LucaSchenetti/ESP32-Analog-Board/3-Gerber File & BOM/BOM_Rev_B.xlsx

Comment | Designator | Footprint | JLCPCB Part #（optional）
10u | C1, C3, C42, C48, C57 | CAP_0402 | C15525
100n | C2, C4, C8, C9, C10, C15, C16, C17, C18, C20, C21, C22, C31, C33, C34, C39, C43, C49, C58, C63, C64, C76 | CAP_0402 | C307331
1u | C5, C6, C7, C32, C35, C40, C62, C65 | CAP_0402 | C52923
1p2 | C11 | CAP_0402 | C76899
1p5 | C12 | CAP_0402 | C76900
15p | C13, C14 | CAP_0402 | C1548
22n | C19 | CAP_0402 | C1532
10u | C23 | CAP_ALEL_5x5.4 | C46550416
4u7 | C24, C53 | CAP_0805 | C98192
10u | C25, C27, C54, C67 | CAP_0805 | C440198
100n | C26, C68, C69, C79 | CAP_0603 | C14663
1u | C28, C44, C45, C46, C47 | CAP_0805 | C28323
10u | C30, C36, C37, C38, C56, C77, C78 | CAP_0603 | C194427
4u7 | C41 | CAP_0402 | C23733
2n7 | C50, C52 | CAP_0402 | C106251
27n | C51 | CAP_0402 | C880636
1u | C55 | CAP_0603 | C15849
1n | C59, C61 | CAP_0402 | C1523
10n | C60 | CAP_0402 | C15195
47u | C66 | CAP_ALEL_6.3x5.4 | C48971023
47n | C70 | CAP_0603 | C1622
47p | C71 | CAP_0603 | C1671
22u | C72, C73, C81, C82 | CAP_0603 | C59461
2u2 | C74, C75 | CAP_0402 | C12530
56p | C80 | CAP_0603 | C39148
DIODE 300mA 75V | D1, D6, D11 | 1N4148W | C917030
BLUE | D2 | LED_0603_BLUE | C965807
RGB_LED | D3 | XL-2012RGBC | C965848
YELLOW | D4 | LED_0603_YELLOW | C89811
Schottky Diodes | D5, D9 | BAT54S | C7420333
TVS 30V Bidirectional | D7 | SMBJ30CA | C83847
BIDI TVS 36V | D8, D12, D13, D14 | SMAJ33CA | C19077549
BIDI TVS 24V | D10 | SMAJ30CA | C10755
ZENER DIODE 15V | D15 | BZT52C15 | C19077412
BIDI TVS 30V | D16, D17 | SMAJ30CA | C10755
ESD Protection TVS 6.0V | D18 | SMF6.0CA | C123791
TWO LED GREEN | D19 | TJ-L3F2LTQYKMQFLC7K-A5 | C20613347
PPTC 100mA 60V | F1, F2 | JK-nSMD010/60V | C2830236
RESETTABLE FUSE 100mA | F3 | BSMD1812-010-60V | C883137
PTC 60V 500mA | F4 | mSMD050-60V | C70113
120R | FB1 | FB_0402 | C76891
DPDT | J1 | 2MD3T2B1M6RES | C545196
2nH | L1 | IND_0402 | C18216
2n7 | L2 | IND_0402 | C77108
6.8uH | L3 | FXL0530-6R8-M | C177249
4.7uH | L4 | IND-SMD_L4.4-W4.2 | C5349668
WJ500V-5.08-4P | P1 | WJ500V-5.08-4P | C2915641
WJ500V-5.08-5P | P2 | WJ500V-5.08-5P | C2927513
2P PLUGGABLE TERMINAL BLOCK 3.81MM | P3 | WJ15EDGRC-3.81-2P | C8387
MALE CONN 2P 3.81mm | P4 | WJ15EDGK-3.81-2P | C8466
N-Channel Vgs=30V 5.7A | Q1 | AO3400A | C20917
NPN MOSFET 100V | Q2 | IRLR3110ZTRPBF | C67277
P-Mosfet 60V 3A | Q3 | BSP315P | C5246415
180R | R1, R6 | RES_0402 | C138045
1K | R2, R5, R8, R53, R54 | RES_0402 | C11702
5K1 | R3, R4, R51, R52 | RES_0402 | C25905
75R | R7, R9 | RES_0402 | C25133
4K7 | R10 | RES_0603 | C23162
100K | R11, R47 | RES_0603 | C25803
100K | R12 | RES_0402 | C25741
10K | R13 | RES_0805 | C17414
33R | R14, R17 | RES_0603 | C23140
10K | R15, R41, R44 | RES_0402 | C25744
25R5 | R16, R34 | RES_2512 | C2775912
47R | R18, R28 | RES_0603 | C23182
15K4 | R19 | RES_0603 | C2933150
1K | R20 | RES_0603 | C21190
2K2 | R21 | RES_0603 | C4190
240R | R22 | RES_0603 | C23350
15K | R23 | RES_0805 | C17475
715R | R24 | RES_0603 | C2998136
10R | R25, R36, R38 | RES_0402 | C25077
1M13 | R26 | RES_0402 | C51048313
499K | R27 | RES_0402 | C2998054
5K1 | R29 | RES_2010 | C2999618
4K12 | R30, R35 | RES_0603 | C23041
47R | R31, R32, R33, R39 | RES_0402 | C25118
470R | R37 | RES_2010 | C2933989
90K9 | R40 | RES_0603 | C23129
10K | R42 | RES_0603 | C25804
9K09 | R43 | RES_0603 | C23125
4R7 | R45 | RES_2512 | C25489
158K | R46 | RES_0603 | C22883
30K1 | R48, R56 | RES_0603 | C137745
150K | R49 | RES_0402 | C93947
68K | R50 | RES_0402 | C2909379
93K1 | R55 | RES_0603 | C23266
TS-1088-AR02016 | SW1, SW2 | TS-1088-AR02016 | C720477
Passive Buzzer 4kHz | U1 | KLJ-4020 | C556936
TRANSISTOR NPN | U2 | SS8050 | C2150
ESP32-S3 8MB IN FLASH | U3 | ESP32-S3FN8 | C2913196
Schmitt Trigger 1.65V~5.5V | U4 | 74LVC1G14GW,125 | C265125
Digital to Analog Converters 12 SPI Voltage Buffer | U5 | AD5412AREZ-REEL7 | C27993
Precision Op Amps | U6 | OP184ESZ-REEL7 | C209423
LDO 100mA 2,2-37V | U7, U10 | LM317LDR2G | C7940
INVERTED CHARGE PUMP 2.7V~5.5V | U8 | LM27761DSGR | C129351
Digital Isolators 4 IN - 2 OUT | U9, U13 | NSI8262W1-DSWR | C5441133
ADC 24-Bit 4-Channel | U11 | ADS1220IPWR | C48263
LDO 3,3V 250mA | U12 | HT7333-A | C347191
3.8V~32V 3A 500kHz | U14, U16 | AP63301WU-7 | C2158003
TVS USB 2.0 ±25-kV | U15 | TPD2E2U06DRLR | C1972959
USB-C CONNECTOR 16P VERTICAL | USB1 | TYPEC-305-ACP16H458 | C5454943
40MHz | X1 | XTAL_3225 | C5261245
4.096MHz CMOS ±10ppm ±20ppm | X2 | OT32254.096MJBA4SL | C2831395
Isolated Power IN 4.5V~5.5V OUT 24V 2W | Y1 | B0524S-2WR3 | C5369477
Isolated Power IN 4.5V~5.5V OUT 24V | Y2 | B0524S-1WR3 | C7500908
Isolated Power 21.6V~26.4V | Y3 | B0505S-1WR3 | C7465178
