LucaSchenetti/ESP32-Analog-Board/10-3D Case/STEP FILE/BASE.step

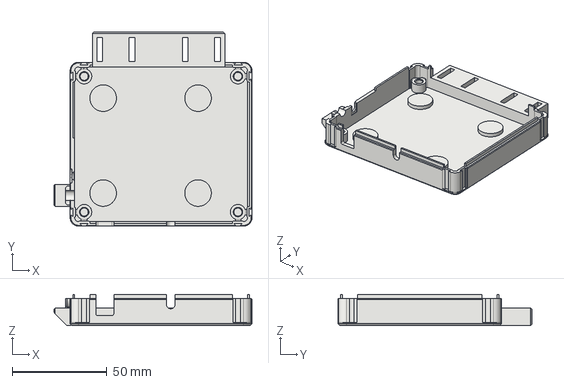
[picture p5: CAD file, 2026-11-05]
10-3D Case/STEP FILE/BASE.step
104.3 x 102.3 x 16.4 mm
