LucaSchenetti/ESP32-Analog-Board/10-3D Case/STL FILE/LIGHTPIPE_RST.stl

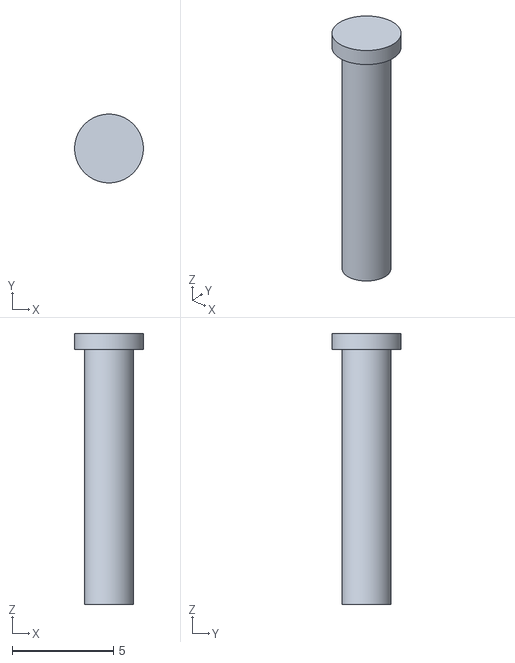
[picture p6: CAD file, 2026-11-05]
10-3D Case/STL FILE/LIGHTPIPE_RST.stl
3.40 x 3.40 x 13.4
