LucaSchenetti/ESP32-Analog-Board/10-3D Case/STEP FILE/LID.step

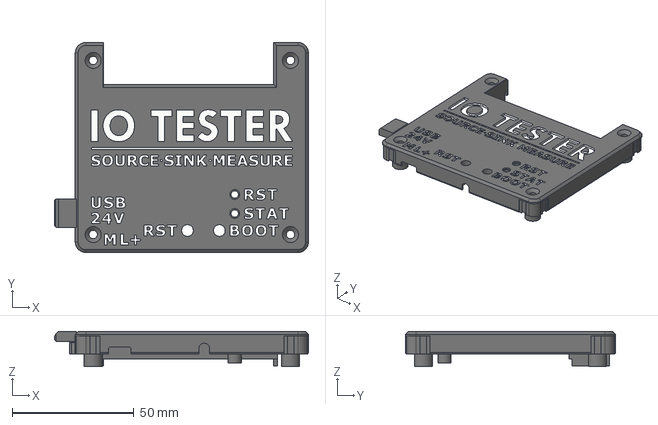
[picture p7: CAD file, 2026-11-05]
10-3D Case/STEP FILE/LID.step
104.3 x 86.3 x 14.4 mm
