LucaSchenetti/ESP32-Analog-Board/10-3D Case/STEP FILE/BUTTONS_RST-BOOT.step

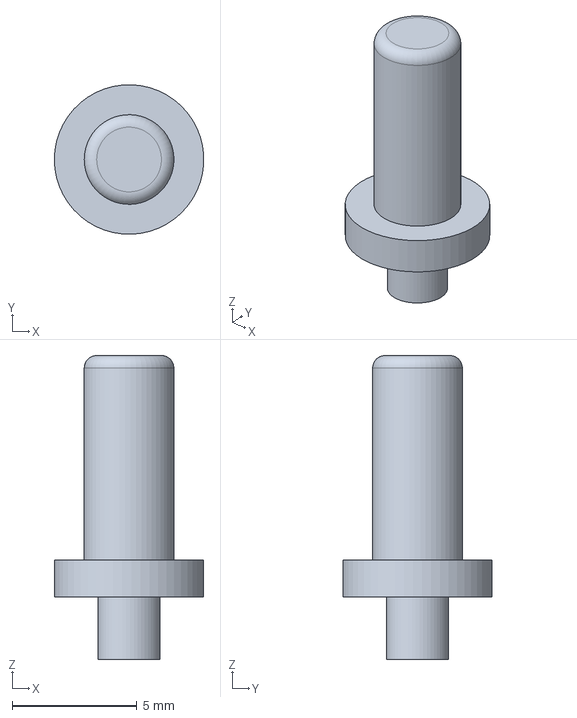
[picture p8: CAD file, 2026-11-05]
10-3D Case/STEP FILE/BUTTONS_RST-BOOT.step
5.99 x 6.00 x 12.2 mm
