LucaSchenetti/ESP32-Analog-Board/10-3D Case/STEP FILE/LIGHTPIPE_STAT_RST.step

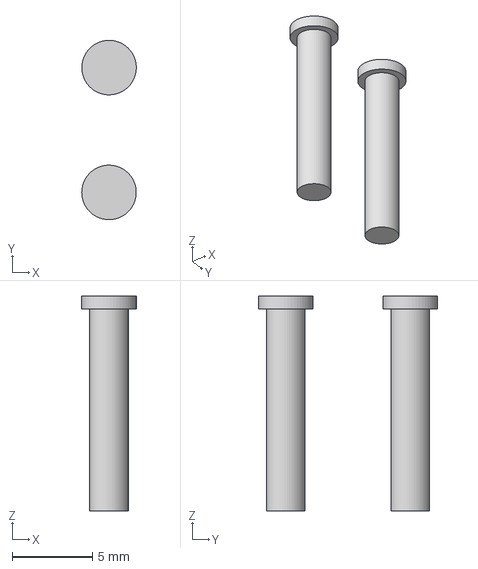
[picture p9: CAD file, 2026-11-05]
10-3D Case/STEP FILE/LIGHTPIPE_STAT_RST.step
3.40 x 11.2 x 13.4 mm
