LucaSchenetti/ESP32-Analog-Board/10-3D Case/STEP FILE/CORNER_BUMPER.step

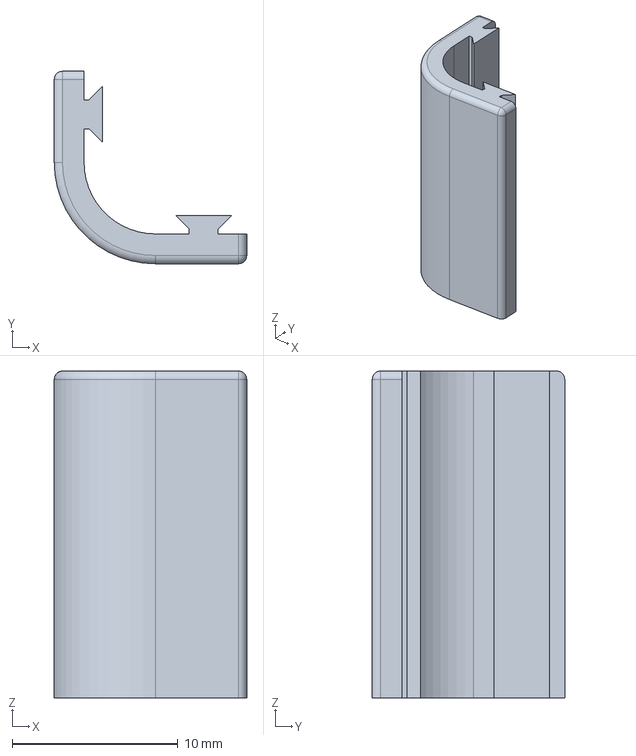
[picture p10: CAD file, 2026-11-05]
10-3D Case/STEP FILE/CORNER_BUMPER.step
11.6 x 11.6 x 19.7 mm
