LucaSchenetti/ESP32-Analog-Board/(list of files, cad)

Other CAD files:
10-3D Case/STL FILE/LIGHTPIPE_STAT.stl
10-3D Case/STL FILE/BASE.stl
10-3D Case/STL FILE/BUTTONS_RST-BOOT.stl
10-3D Case/STL FILE/CORNER_BUMPER.stl
10-3D Case/STL FILE/LID.stl
