LucaSchenetti/ESP32-Analog-Board/(list of files, drawings)

Other design files:
1-Draw/ADC.SchDoc
1-Draw/BD.SchDoc
1-Draw/COVER PAGE.SchDoc
1-Draw/DAC.SchDoc
1-Draw/ESP32-ANALOG BOARD.PrjPcb
1-Draw/INFO.SchDoc
1-Draw/MCU.SchDoc
1-Draw/PCB-LAYOUT.PcbDoc
1-Draw/PWR RAIL.SchDoc
