LucaSchenetti/ESP32-Analog-Board/6-Firmware/data/js/i18n.js

/*
  IO Tester — traduzioni / translations
  IT: Testi dell'interfaccia in italiano e inglese. Gli elementi con data-i18n="chiave" vengono
      tradotti in automatico; il codice usa t('chiave', {variabili}). La lingua scelta resta salvata.
  EN: Interface texts in Italian and English. Elements with data-i18n="key" are translated
      automatically; code uses t('key', {variables}). The chosen language is remembered.
*/
'use strict';

const I18N = {
  it: {
    brand_sub: 'Calibratore I/O analogici',
    conn_wait: 'Connessione…',
    conn_ok: 'Collegato',
    conn_lost: 'Connessione persa',
    cmd_fail: 'Comando non riuscito',
    theme: 'Tema chiaro / scuro',

    out_v: 'Uscita tensione attiva: {v} V',
    out_i: 'Uscita corrente attiva: {v} mA',
    out_sink: 'Uscita corrente 2F attiva: {v} mA',
    out_fault: '⚠ FAULT AD5412: controllare il collegamento',
    btn_off: 'SPEGNI USCITE',

    live_title: 'Misure in tempo reale',
    live_hint: 'Aggiornamento ogni secondo',
    in_voltage: 'Ingresso Tensione',
    in_current: 'Ingresso Corrente',
    output: 'Uscita',
    out_off: 'Spenta',
    out_off_sub: 'Nessuna uscita attiva',
    mode_v: 'Tensione 0–10 V',
    mode_i: 'Corrente 4–20 mA',
    mode_sink: 'Sink 2 fili',
    range_minmax: 'Min {min} · max {max}',
    flag_over: 'FUORI SCALA',
    flag_neg: 'POLARITÀ?',
    flag_fault: 'FAULT',

    grp_gen: 'Genera',
    grp_meas: 'Misura',
    grp_loop: 'Trasmettitori a 2 Fili',
    grp_tool: 'Strumento',
    fn_voltage: 'Tensione',
    fn_current: 'Corrente 4F',
    fn_sim: 'Corrente 2F',
    fn_sim_range: '4 – 20 mA passivo · 2 fili',
    fn_cur_active: '4 – 20 mA attiva',
    fn_cur_4w: 'Corrente 4F',
    fn_cur_4w_range: '4 – 20 mA · sorgente attiva',
    fn_cur_2w: 'Corrente 2F',
    fn_cur_2w_range: '4 – 20 mA · alimentato da L+ 24 V',
    w4: '4 fili',
    w2: '2 fili',
    fn_power: 'Alimenta e Misura',
    fn_cal: 'Calibrazione',
    fn_cal_range: '5 canali',
    fn_diag: 'Diagnostica',
    fn_diag_range: 'Collaudo e test',
    soon: 'Presto',

    sys_title: 'Stato sistema',
    sec_supply: 'Alimentazione',
    sec_out: 'Uscita · AD5412',
    sec_in: 'Ingresso · ADS1220',
    sec_esp: 'Controllore · ESP32-S3',
    sec_wifi: 'WiFi',
    sec_cal: 'Calibrazione',
    k_source: 'Sorgente',
    k_vusb: 'Tensione USB',
    k_ext24: 'Ingresso 24 V',
    k_ext5: 'Ingresso 5 V',
    k_state: 'Stato',
    k_selftest: 'Test di Avvio',
    k_fault: 'FAULT',
    k_overtemp: 'Sovratemperatura',
    k_temp: 'Temperatura',
    k_conv: 'Conversioni',
    k_errors: 'Errori',
    k_heap: 'Memoria Libera',
    k_heap_min: 'Memoria Minima',
    k_uptime: 'In Funzione da',
    k_reset: 'Ultimo Riavvio',
    k_network: 'Rete',
    k_channel: 'Canale',
    k_tx: 'Potenza TX',
    k_clients: 'Dispositivi',
    k_rssi: 'Segnale',
    cal_sink: 'Sink 2 fili',
    cal_vout: 'Uscita tensione',
    cal_iout: 'Uscita corrente',
    cal_vin: 'Ingresso tensione',
    cal_iin: 'Ingresso corrente',

    v_usb: 'USB / powerbank',
    v_field: '24 V di campo',
    v_present: 'Presente',
    v_absent: 'Assente',
    v_ok: 'OK',
    v_failed: 'FALLITO',
    v_no: 'No',
    v_yes: 'SÌ',
    v_off: 'Spenta',
    v_none: 'Non calibrato',
    v_low: 'Bassa',
    rst_poweron: 'Accensione',
    rst_sw: 'Software / OTA',
    rst_panic: 'Errore firmware',
    rst_wdt: 'Watchdog',
    rst_brownout: 'Calo di tensione',
    rst_deepsleep: 'Risveglio',
    rst_ext: 'Pulsante reset',
    rst_other: 'Altro',

    footer_diag: 'Diagnostica tecnica',

    // Pagina "Genera Tensione" / "Generate Voltage" page
    nav_home: 'Home',
    nav_menu: 'Menu',
    nav_close: 'Chiudi menu',
    gv_title: 'Genera Tensione',
    gv_sub: '0 – 10 V · Uscita Isolata',
    st_on: 'ATTIVA',
    st_off: 'SPENTA',
    st_other: 'ALTRA USCITA ATTIVA',
    sp_title: 'Impostazione',
    sp_now: 'Uscita attuale',
    sp_label: 'Valore da generare',
    sp_quick: 'Valori rapidi',
    sp_step: 'Regolazione fine',
    btn_enable: 'ATTIVA USCITA',
    btn_enable_s: 'ATTIVA SIMULAZIONE',
    btn_apply: 'APPLICA',
    btn_apply_v: 'APPLICA {v} {u}',
    btn_stop: 'SPEGNI',
    sp_hint: 'Valori rapidi e regolazione fine si applicano subito. Un valore scritto a mano si conferma con APPLICA o con il tasto Invio.',
    sp_err: 'Valore fuori campo: {min} – {max} {u}',
    sp_switch: 'Attivando questa uscita l\'altra uscita attiva verrà spenta.',
    rb_title: 'Dettagli Tecnici',
    rb_sub: 'Rilettura dal Chip AD5412',
    rb_expected: 'Valore Atteso',
    rb_nominal: 'Valore Nominale',
    rb_code: 'Codice DAC Scritto / Riletto',
    rb_ctrl: 'Registro di Controllo',
    rb_cal: 'Calibrazione Uscita',
    rb_loop: 'Verifica su Ingresso {p}',
    rb_loop_hint_v: 'Solo collegando P1.4 V+ → P2.2 V+ e P1.1 COM → P2.1 V−',
    rb_delta: 'Scarto {d} {u}',
    cal_yes: 'Calibrata il {d}',
    wr_title: 'Collegamento',
    wr_cal: 'IO Tester · P1 OUTPUT',
    wr_plc: 'Ingresso Analogico',
    wr_plc_sub_v: 'PLC · 0 – 10 V',
    wr_free: 'Libero',
    wr_note_v: 'Collegare solo P1.4 V+ e P1.1 COM. P1.2 SIM+ e P1.3 mA+ restano liberi. Il multimetro, se serve, va in parallelo ai morsetti del PLC.',
    in_title: 'Informazioni sulla Misura',
    i_range_k: 'Campo',
    i_range_v: '0 – 10 V (massimo 9,9976 V)',
    i_res_k: 'Risoluzione',
    i_res_v: '2,44 mV · 12 bit',
    i_acc_k: 'Precisione',
    i_acc_v: '±0,1% del fondo scala a 25 °C (AD5412, Tab. 2) · misurata ±0,02% in loopback',
    i_load_k: 'Carico',
    i_load_v: 'Minimo 1 kΩ; consigliato ≥ 10 kΩ (ingressi PLC tipici ≥ 100 kΩ)',
    i_short_k: 'Cortocircuito',
    i_short_v: 'Corrente limitata a circa 17–20 mA (AD5412, Tab. 2), nessun danno',
    i_iso_k: 'Isolamento',
    i_iso_v: 'Uscita isolata: P1.1 COM è separato dalla massa dello strumento',
    i_safe_k: 'Sicurezza',
    i_safe_v: 'Si spegne da sola se il dispositivo si scollega dal WiFi; non collegare a sorgenti di tensione',
    fault_v: 'FAULT AD5412: possibile sovratemperatura, controllare il carico su P1.4 V+ / P1.1 COM',
    fault_i: 'Circuito aperto o carico troppo alto: controllare il collegamento su P1.3 mA+ / P1.1 COM',
    // Pagina "Genera Corrente 4F" / "Generate Current 4W" page
    fault_s: 'FAULT AD5412 (sovratemperatura): spegnere e controllare il collegamento',
    si_title: 'Genera Corrente 2F',
    si_sub: '4 – 20 mA Passivo · 2 Fili, Loop Alimentato dal PLC',
    sp_namur: 'Fuori campo e guasto (NAMUR NE 43)',
    rb_loop_hint_s: 'Solo collegando P2.5 L+ → P1.2 SIM+ e P1.1 COM → P2.4 mA+',
    wr_plc_sub_s: 'PLC · 4–20 mA, 2 fili',
    wr_note_s: 'Il PLC alimenta il loop: la sua uscita di alimentazione del canale (L+ o M+, secondo il modulo) va su P1.2 SIM+, il suo ingresso di misura su P1.1 COM. P1.3 mA+ e P1.4 V+ restano liberi. Il multimetro, se serve, va in serie.',
    i_range_s: '0 – 22 mA (4 – 20 mA e valori NAMUR NE 43)',
    i_res_s: '5,84 µA · 12 bit (2,391 mA/V dal partitore R19/R20 su R16 25,5 Ω)',
    i_acc_s: '±0,21% di 16 mA dopo la calibrazione (collaudo fase 7) · deriva fino a ±0,19% su ±25 °C (R16, R19, R20 1%, 75 ppm/°C)',
    i_vloop_k: 'Tensione del Loop',
    i_vloop_s: '24 V tipici, massimo 30 V (D8 SMAJ33CA, V_RWM 33 V) · a 20 mA Q2 dissipa fino a 0,5 W',
    i_open_s: 'Non rilevato dallo strumento: lo segnala il PLC come rottura filo',
    i_rev_k: 'Polarità Invertita',
    i_rev_s: 'Protetta da D6: corrente 0 mA, nessun danno (collaudo 8.1)',
    i_iso_s: 'Isolato: P1.1 COM è separato dalla massa dello strumento · P1.4 V+ porta la tensione di comando (0 – 9,2 V)',
    i_safe_s: 'Interlock hardware Q1: sink bloccato all\'accensione e quando il dispositivo si scollega dal WiFi',
    mv_title: 'Misura Tensione',
    mv_sub: '0 – 10 V · Ingresso Isolato',
    ms_title: 'Misura',
    ms_ok: 'IN MISURA',
    ms_nosig: 'NESSUN SEGNALE',
    ms_sat: 'FUORI SCALA',
    ms_neg: 'NEGATIVA',
    ms_hold: 'HOLD',
    ms_pct: '{p} % del campo',
    ms_sat_v: 'Fuori scala: tensione oltre 20,6 V. Controllare il segnale e il collegamento.',
    ms_neg_v: 'Tensione negativa: invertire i fili su P2.2 V+ e P2.1 V−. Le tensioni negative non sono misurabili.',
    btn_hold: 'HOLD',
    btn_resume: 'RIPRENDI',
    btn_reset_stats: 'AZZERA STATISTICHE',
    ms_stats: 'Statistiche',
    ms_stats_sub: 'Dall\'Apertura della Pagina o dall\'Azzeramento',
    ms_min: 'Minimo',
    ms_max: 'Massimo',
    ms_mean: 'Media',
    ms_sd: 'Deviazione Standard',
    ms_pp: 'Picco-Picco',
    ms_n: 'Campioni · Durata',
    ms_trend: 'Andamento · Ultimi 2 Minuti',
    ms_now: 'Ora',
    ms_rb_sub: 'Lettura dal Chip ADS1220',
    ms_nom: 'Valore con Componenti Nominali',
    ms_win: 'Rumore Picco-Picco (Ultime 10 Letture)',
    ms_code: 'Codice ADC (24 Bit)',
    ms_satk: 'Fuori Scala',
    ms_cal: 'Calibrazione Ingresso',
    ms_temp: 'Temperatura ADS1220',
    ms_conv: 'Conversioni / Errori',
    ms_cmp: 'Confronto con Uscita {p}',
    ms_cmp_off: 'Uscita non attiva',
    ms_cmp_hint_v: 'Solo collegando P1.4 V+ → P2.2 V+ e P1.1 COM → P2.1 V− con "Genera Tensione" attiva',
    nm_low_fail: 'Guasto: sotto 3,6 mA',
    nm_under: 'Sotto campo: 3,6 – 3,8 mA',
    nm_ok: 'Nel campo di misura',
    nm_over: 'Sopra campo: 20,5 – 21 mA',
    nm_high_fail: 'Guasto: da 21 mA',
    wr_cal_in: 'IO Tester · P2 INPUT',
    wr_plc_out: 'Uscita Analogica',
    wr_plc_sub_mv: 'PLC · 0–10 V',
    wr_note_mv: 'Collegare l\'uscita del PLC tra P2.2 V+ e P2.1 V−; P2.3, P2.4 e P2.5 restano liberi. Il PLC vede un carico di 100,9 kΩ. Per verificare lo strumento: P1.4 V+ → P2.2 V+ e P1.1 COM → P2.1 V− con "Genera Tensione".',
    i_range_mv: '0 – 10 V · lettura fino a 20,6 V (2,048 V × 10,09)',
    i_res_mv: '0,1 mV mostrati · rumore all\'ingresso 39 µV rms, 135 µV picco-picco (ADS1220 Tab. 7-3: 3,89 µV rms a 20 SPS, PGA escluso, × 10,09), ridotto dalla media',
    i_acc_mv: 'Senza calibrazione entro ±0,25% (riferimento interno ±0,15%, ADS1220 §6.5; partitore 0,05% + 0,05%; guadagno ±0,015%) · riferimento misurato entro 0,02% da quello dell\'AD5412',
    i_zin_k: 'Impedenza d\'Ingresso',
    i_zin_mv: '100,9 kΩ (90,9 kΩ + 10 kΩ, 0,05%): 99 µA a 10 V',
    i_rej_k: 'Reiezione 50/60 Hz',
    i_rej_m: 'Almeno 90 dB a 20 SPS con oscillatore esterno 4,096 MHz (ADS1220 §6.5, NMRR)',
    i_upd_k: 'Aggiornamento',
    i_upd_m: 'Media mobile di 10 conversioni (circa 1 s), pagina aggiornata ogni secondo',
    i_iso_mv: 'Ingresso isolato: P2.1 V− è separato dalla massa dello strumento e da P1.1 COM',
    i_safe_mv: 'Protetto da SMAJ33CA + PPTC, provato a +24 V e −24 V (collaudo 8.2, 8.3) · tensioni negative non misurabili',
    mi4_title: 'Misura Corrente 4F',
    mi4_sub: '4 – 20 mA · Sorgente Attiva, Ingresso Isolato',
    mi2_title: 'Misura Corrente 2F',
    mi2_sub: '4 – 20 mA · Trasmettitore Alimentato da L+ 24 V',
    wr_plc_sub_mi4: 'PLC · 4–20 mA attiva',
    wr_tx: 'Trasmettitore',
    wr_tx_sub: '2 fili · 4–20 mA',
    wr_note_mi4: 'Collegare la sorgente attiva tra P2.4 mA+ (corrente entrante) e P2.3 mA−; P2.1, P2.2 e P2.5 restano liberi. La sorgente vede 27 – 41 Ω. Per verificare lo strumento: P1.3 mA+ → P2.4 mA+ e P1.1 COM → P2.3 mA− con "Genera Corrente 4F".',
    wr_note_mi2: 'Il + del trasmettitore va su P2.5 L+, il − su P2.4 mA+; P2.1, P2.2 e P2.3 restano liberi. Lo strumento alimenta il loop e misura la corrente. Per verificare lo strumento: P2.5 L+ → P1.2 SIM+ e P1.1 COM → P2.4 mA+ con "Genera Corrente 2F".',
    ms_sat_i: 'Fuori scala: corrente oltre 40 mA. Controllare il collegamento.',
    ms_neg_i4: 'Corrente negativa: invertire i fili su P2.4 mA+ e P2.3 mA−.',
    ms_neg_i2: 'Corrente negativa: controllare il collegamento del trasmettitore.',
    ms_cmp_hint_i4: 'Solo collegando P1.3 mA+ → P2.4 mA+ e P1.1 COM → P2.3 mA− con "Genera Corrente 4F" attiva',
    ms_cmp_hint_i2: 'Solo collegando P2.5 L+ → P1.2 SIM+ e P1.1 COM → P2.4 mA+ con "Genera Corrente 2F" attiva',
    i_range_mi: '4 – 20 mA · lettura fino a 40,1 mA (1,024 V su shunt 25,5 Ω, guadagno 2)',
    i_res_mi: '0,1 µA mostrati · rumore 0,07 µA rms, 0,27 µA picco-picco (ADS1220 Tab. 7-3: 1,85 µV rms a 20 SPS, guadagno 2, PGA escluso, su 25,5 Ω), ridotto dalla media',
    i_acc_mi: 'Senza calibrazione entro ±0,22% (riferimento interno ±0,15%, ADS1220 §6.5; shunt R34 0,05%; guadagno ±0,015%) · in loopback −0,11% rispetto all\'uscita AD5412',
    i_burden_k: 'Caduta di Tensione',
    i_burden_mi4: '27 – 41 Ω (shunt 25,5 Ω + PPTC): 0,54 – 0,81 V a 20 mA',
    i_lplus_k: 'Alimentazione L+',
    i_lplus_mi2: '23,9 V a vuoto (B0524S-2WR3), limitata a 26,6 mA da LM317L + R28 47 Ω (collaudo 8.9)',
    i_iso_mi: 'Ingresso isolato: P2.3 mA− è separato dalla massa dello strumento e da P1.1 COM',
    i_safe_mi4: 'Protetto da SMAJ33CA + PPTC · non collegare una tensione direttamente tra P2.4 mA+ e P2.3 mA−',
    i_safe_mi2: 'Un cortocircuito tra P2.5 L+ e P2.4 mA+ è sicuro: corrente limitata a 26,6 mA (collaudo 8.9)',
    cal_title: 'Calibrazione',
    cal_sub: 'Ingressi con Multimetro di Riferimento, Uscite in Loopback',
    cal_st_idle: 'PRONTA',
    cal_st_run: 'IN CORSO',
    cal_chans: 'Canali',
    cal_order: 'Ordine Consigliato: 1 → 5',
    cal_proc: 'Procedura',
    cal_info: 'Informazioni sul Metodo',
    cal_pick: 'Scegliere un canale con CALIBRA. Calibrare prima gli ingressi (1, 2), ma solo con un multimetro di almeno 4½ cifre: le uscite (3 – 5) vengono confrontate con gli ingressi. Con un multimetro meno preciso calibrare solo le uscite.',
    ch_vin: 'Ingresso Tensione',
    ch_iin: 'Ingresso Corrente',
    ch_vout: 'Uscita Tensione',
    ch_iout: 'Uscita Corrente 4F',
    ch_sink: 'Uscita Corrente 2F',
    cal_yes_t: 'Calibrato il {d} a {tc} °C',
    k_gain: 'Guadagno',
    k_offset: 'Offset',
    cal_m_in: 'Due punti con multimetro di riferimento',
    cal_m_out: 'Automatica in loopback, 5 punti + verifica',
    btn_calibrate: 'CALIBRA',
    btn_clear: 'CANCELLA',
    cal_clear_confirm: 'Cancellare la calibrazione di "{n}"? Il canale tornerà ai valori nominali.',
    dmm_v: 'Multimetro · V DC',
    dmm_ma: 'Multimetro · mA DC',
    wr_cal_vin: 'P1.4 V+ → P2.2 V+ e P1.1 COM → P2.1 V−; multimetro in V DC in parallelo su P2.2 V+ / P2.1 V−. Con una sorgente esterna: collegarla al posto di P1.',
    wr_cal_iin: 'P1.3 mA+ → multimetro (mA) → P2.4 mA+; P2.3 mA− → P1.1 COM. Con una sorgente esterna: collegarla al posto di P1, sempre in serie al multimetro.',
    wr_cal_vout: 'P1.4 V+ → P2.2 V+ e P1.1 COM → P2.1 V−. Nessun altro carico su P1.4 V+.',
    wr_cal_iout: 'P1.3 mA+ → P2.4 mA+ e P2.3 mA− → P1.1 COM.',
    wr_cal_sink: 'P2.5 L+ → P1.2 SIM+ e P1.1 COM → P2.4 mA+: L+ alimenta il loop e l\'ingresso misura la corrente.',
    cal_in_intro_vin: 'Due punti, circa 1 V e 9 V. Lo strumento genera la tensione su P1.4 V+; il multimetro dà il valore vero, che va scritto nella pagina.',
    cal_in_intro_iin: 'Due punti, 4 mA e 20 mA. Lo strumento genera la corrente su P1.3 mA+; il multimetro in serie dà il valore vero, che va scritto nella pagina.',
    cal_chk_warm: 'Strumento acceso da almeno 15 minuti',
    cal_chk_dmm_vin: 'Multimetro in V DC, portata 10 V o automatica',
    cal_chk_dmm_iin: 'Multimetro in mA DC, puntale sulla boccola mA',
    cal_chk_wiring: 'Collegamento come nel disegno a fianco',
    cal_chk_free: 'Nessun altro collegamento sui morsetti usati',
    cal_ext: 'Uso una sorgente esterna invece dell\'uscita dello strumento',
    cal_dmm_warn: 'Multimetro con meno di 4½ cifre (per esempio 2 decimali) o precisione peggiore di ±0,075%: non calibrare gli ingressi, peggiorerebbero. Calibrare solo le uscite (3 – 5).',
    cal_dmm_ok: 'Il mio multimetro ha almeno 4½ cifre e precisione di ±0,075% o migliore',
    btn_start: 'INIZIA',
    btn_cancel: 'ANNULLA',
    cal_point_h: 'Punto {k} di 2: circa {v} {u}',
    cal_point_ext: 'Applicare circa {v} {u} con la sorgente esterna e attendere la lettura stabile.',
    cal_point_int_vin: 'Lo strumento genera circa {v} {u} su P1.4 V+. Attendere la lettura stabile, poi scrivere il valore del multimetro.',
    cal_point_int_iin: 'Lo strumento genera circa {v} {u} su P1.3 mA+. Attendere la lettura stabile, poi scrivere il valore del multimetro.',
    cal_live: 'Lettura dello strumento (valori nominali)',
    cal_ref_label: 'Valore letto sul multimetro',
    btn_confirm_pt: 'CONFERMA PUNTO {k}',
    cal_stable: 'Stabile',
    cal_settling: 'In assestamento',
    cal_e_ref: 'Il valore del multimetro è troppo diverso dalla lettura: controllare unità ({u}) e collegamento.',
    cal_e_span: 'Punti troppo vicini: servono almeno {s} {u} di distanza.',
    cal_e_limits: 'Coefficienti fuori dai limiti (guadagno ±5% o offset troppo grande): controllare collegamento e valori.',
    cal_e_save: 'Salvataggio non riuscito.',
    cal_pt: 'Punto {k}',
    cal_ver: 'Verifica {k}',
    cal_th_nom: 'Lettura [{u}]',
    cal_th_ref: 'Multimetro [{u}]',
    cal_th_set: 'Impostato [{u}]',
    cal_th_meas: 'Misurato [{u}]',
    cal_th_dev: 'Scarto',
    cal_save_hint: 'Valore reale = guadagno × lettura nominale + offset. Salvando, il nuovo valore si applica subito a tutte le misure.',
    btn_save_cal: 'SALVA CALIBRAZIONE',
    cal_saved: 'Calibrazione salvata in memoria (NVS).',
    cal_next_vin: 'Ora si può calibrare l\'uscita tensione (3) in loopback.',
    cal_next_iin: 'Ora si possono calibrare uscita corrente (4) e simulazione trasmettitore (5) in loopback.',
    btn_close: 'CHIUDI',
    cal_out_intro_vout: 'Procedura automatica, circa 20 s: 5 punti senza correzione (1, 3, 5, 7, 9 V), retta ai minimi quadrati, salvataggio e verifica a 1, 5 e 9 V con la correzione.',
    cal_out_intro_iout: 'Procedura automatica, circa 20 s: 5 punti senza correzione (4, 8, 12, 16, 20 mA), retta ai minimi quadrati, salvataggio e verifica a 4, 12 e 20 mA con la correzione.',
    cal_out_intro_sink: 'Procedura automatica, circa 20 s: 5 punti senza correzione (4, 8, 12, 16, 20 mA), retta ai minimi quadrati, salvataggio e verifica a 4, 12 e 20 mA con la correzione.',
    cal_ref_ok: 'Riferimento: {n}, calibrato il {d}.',
    cal_ref_missing: '{n} non è calibrato: il risultato dipenderà dai valori nominali dell\'ADS1220 (±0,25%). Conviene calibrarlo prima.',
    btn_start_auto: 'AVVIA CALIBRAZIONE',
    cal_run_pt: 'Misura del punto {k} di {n}…',
    cal_run_ver: 'Verifica {k} di {n}…',
    btn_abort: 'INTERROMPI',
    cal_ver_max: 'Errore massimo in verifica',
    cal_c_timeout: 'L\'ADS1220 non risponde: procedura interrotta, coefficienti non modificati.',
    cal_c_off: 'Uscita spenta durante la procedura (interruzione, comando esterno o WiFi scollegato): coefficienti non modificati.',
    cal_c_wiring: 'Al primo punto l\'ingresso legge un valore anomalo: controllare il collegamento. Coefficienti non modificati.',
    cal_c_limits: 'Coefficienti fuori dai limiti (guadagno ±5% o offset): non salvati. Controllare il collegamento.',
    cal_c_verify: 'Verifica interrotta: i coefficienti sono già stati salvati. Ripetere per controllarli.',
    btn_repeat: 'RIPETI',
    i_cal_order_k: 'Ordine',
    i_cal_order: 'Prima gli ingressi (1, 2) con il multimetro, poi le uscite (3 – 5) in loopback: così anche le uscite sono riferite al multimetro.',
    i_cal_in_k: 'Ingressi',
    i_cal_in: 'Due punti (1 e 9 V; 4 e 20 mA): valore reale = guadagno × lettura nominale + offset.',
    i_cal_out_k: 'Uscite',
    i_cal_out: '5 punti senza correzione, retta ai minimi quadrati, verifica su 3 punti con la correzione; circa 20 s.',
    i_cal_dmm_k: 'Multimetro',
    i_cal_dmm: 'Almeno 4 volte più preciso dell\'obiettivo ±0,3%: ±0,075% o meglio in V DC e in mA DC (5½ cifre consigliato).',
    i_cal_warm_k: 'Preparazione',
    i_cal_warm: 'Strumento acceso da almeno 15 minuti, temperatura ambiente stabile.',
    i_cal_lim_k: 'Limiti',
    i_cal_lim: 'Guadagno entro ±5%, offset entro 0,2 V o 0,5 mA: oltre, i coefficienti non vengono salvati (collegamento sbagliato o guasto).',
    i_cal_mem_k: 'Memoria',
    i_cal_mem: 'Coefficienti in NVS con data e temperatura dell\'ADS1220; restano dopo gli aggiornamenti del firmware (USB e OTA).',
    i_cal_vout_k: 'Uscita Tensione',
    i_cal_vout: 'F1 è fuori dall\'anello di misura: con il carico l\'errore cresce di I × 1,6 – 15 Ω (1 mA → fino a 15 mV).',
    hm_ready: 'Strumento Pronto',
    hm_ready_sub: 'Tutti i controlli superati. Scegliere una funzione.',
    hm_check: 'Da Controllare',
    hm_err: 'Problema Rilevato',
    is_dac: 'Test AD5412 non superato',
    is_adc: 'Test ADS1220 non superato',
    is_fault: 'FAULT AD5412 attivo',
    is_ot: 'Sovratemperatura AD5412',
    is_reset: 'Ultimo riavvio: {r}',
    is_usb: 'Tensione USB bassa ({v} V)',
    is_adcerr: 'Errori di lettura ADS1220: {n}',
    is_rssi: 'Segnale WiFi debole ({r} dBm)',
    hm_c_power: 'Alimentazione',
    hm_pow_field: 'Buck AP63301 → 5 V',
    hm_pow_both: 'Anche USB collegata ({v} V)',
    hm_c_out: 'Uscite',
    hm_c_cal: 'Calibrazione',
    hm_c_wifi: 'WiFi',
    hm_out_off: 'Spente',
    hm_cal_n: '{n} di 5 canali',
    hm_cal_sub: '{n} di 5 canali calibrati',
    hm_inputs: 'Ingressi',
    hm_inputs_hint: 'P2 INPUT · aggiornamento ogni secondo',
    hm_open: 'Apri la misura',
    hm_fn: 'Funzioni',
    hm_sim_sub: '2 fili · P1.2 SIM+',
    hm_i4_sub: 'Sorgente attiva · P2.4 mA+',
    hm_i2_sub: 'Alimentato da P2.5 L+',
    hm_diag_sub: 'Componenti, test, antenna',
    dg_title: 'Diagnostica',
    dg_sub: 'Stato dei Componenti, Test e Antenna',
    dg_st_ok: 'TUTTO OK',
    dg_st_warn: 'DA CONTROLLARE',
    dg_st_bad: 'PROBLEMA',
    k_pin: 'Tensione su GPIO1',
    k_iout_fault: 'Fault IOUT',
    k_status: 'Registro di Stato',
    k_code_v: 'Codice Tensione',
    k_code_i: 'Codice Corrente',
    k_cpu: 'Frequenza CPU',
    k_fw: 'Firmware',
    btn_test: 'ESEGUI TEST SPI',
    dg_dac_hint: 'Il test esegue un reset dell\'AD5412: le uscite attive vengono spente.',
    dg_adc_hint: 'Rilettura dei registri e conversione della temperatura; le misure riprendono subito dopo.',
    dg_dac_confirm: 'Un\'uscita è attiva: il test la spegne. Continuare?',
    dg_pass: 'Superato',
    dg_fail: 'Non superato',
    dg_adc_drdy: 'DRDY OK · temperatura {tc} °C · conversione {ms} ms',
    dg_adc_nodrdy: 'DRDY non arriva (timeout)',
    th_step: 'Passo',
    th_exp: 'Atteso',
    th_read: 'Letto',
    th_stats: 'Min / media / max (30 s)',
    th_rate: 'Giudizio',
    th_ch: 'Canale',
    dg_wifi: 'WiFi e Antenna',
    k_tx_set: 'Imposta Potenza TX',
    dg_clients: 'Dispositivi collegati',
    dg_noclient: 'Nessun dispositivo',
    dg_nets: 'Reti vicine',
    btn_scan: 'SCANSIONA',
    dg_scanning: 'Scansione in corso…',
    dg_scan_age: 'Ultima: {s} s fa · {n} reti',
    dg_hidden: 'nascosta',
    rssi_exc: 'Ottimo',
    rssi_good: 'Buono',
    rssi_poor: 'Scarso',
    rssi_bad: 'Pessimo',
    dg_wifi_hint: 'Soglie indicative (empiriche, non da datasheet): da −50 dBm ottimo, −50…−67 buono, −67…−75 scarso, sotto −75 pessimo. La scansione cambia canale per circa 2 s.',
    dg_io: 'LED e Cicalino',
    dg_led: 'LED RGB (prova per 5 s, poi torna allo stato automatico)',
    c_red: 'Rosso',
    c_green: 'Verde',
    c_blue: 'Blu',
    c_white: 'Bianco',
    c_off: 'Spento',
    dg_buzzer: 'Cicalino',
    k_freq: 'Frequenza',
    btn_beep: 'BEEP',
    btn_sweep: 'SWEEP 2–6 kHz',
    btn_stop_snd: 'STOP',
    dg_legacy: 'Pagina di collaudo completa (tecnica, solo italiano)',
    fn_info: 'Info App',
    up_info: 'Informazioni',
    up_title: 'Info App',
    up_sub: 'Versione, Aggiornamento e Memoria',
    up_built: 'Compilato il',
    up_running: 'Partizione in Uso',
    up_hw: 'Hardware',
    up_author: 'Creatore',
    up_fw: 'Aggiorna Firmware',
    up_fw_sub: 'File .bin dal Browser',
    up_fs: 'Aggiorna Interfaccia',
    up_fs_sub: 'Pagine Web (LittleFS)',
    up_pick: 'Scegli il file .bin',
    up_fw_hint: 'Dal PC: .pio/build/esp32-s3fn8/firmware.bin (dopo pio run)',
    up_fs_hint: 'Dal PC: .pio/build/esp32-s3fn8/littlefs.bin (dopo pio run -t buildfs)',
    up_fw_btn: 'AGGIORNA FIRMWARE',
    up_fs_btn: 'AGGIORNA INTERFACCIA',
    up_cur: 'Versione Attuale',
    up_slot: 'Partizione Attiva → Prossima',
    up_size: 'Dimensione Firmware',
    up_max: 'Spazio per il Nuovo Firmware',
    up_fs_used: 'Spazio Usato',
    up_e_ext: 'Il file deve avere estensione .bin.',
    up_e_empty: 'Il file è vuoto.',
    up_e_magic: 'Non è un firmware ESP32 (manca l\'intestazione 0xE9): forse è littlefs.bin?',
    up_e_chip: 'Firmware per un altro chip (ID {id}): serve un firmware per ESP32-S3.',
    up_e_big: 'File troppo grande: {s} KB, massimo {m} KB.',
    up_e_isfw: 'Questo è un firmware, non l\'immagine dell\'interfaccia: usare il pannello Aggiorna firmware.',
    up_ok_file: 'File valido · {s} KB',
    up_confirm: 'Un\'uscita è attiva: l\'aggiornamento la spegne. Continuare?',
    up_send: 'Invio {p} %',
    up_write: 'Scrittura e verifica…',
    up_reboot: 'Riavvio dello strumento…',
    up_wait: 'Attesa del ricollegamento… {s} s',
    up_done_fw: 'Firmware aggiornato: {v}',
    up_done_fs: 'Interfaccia aggiornata: ricarico la pagina…',
    up_fail: 'Aggiornamento non riuscito: {e}',
    up_timeout: 'Lo strumento non risponde dopo il riavvio: controllare il WiFi, altrimenti ricaricare via USB.',
    up_st_ready: 'PRONTO',
    up_st_busy: 'IN CORSO',
    up_nvs: 'Memoria NVS',
    up_nvs_sub: 'Coefficienti di Calibrazione',
    up_nvs_used: 'Voci Usate / Totali',
    up_th_ch: 'Canale',
    up_th_date: 'Data',
    up_copy: 'COPIA DEI COEFFICIENTI',
    up_copied: 'Copiato negli appunti: incollarlo in un file o in un messaggio.',
    up_copy_fail: 'Selezionare il testo qui sotto e copiarlo a mano.',
    up_dl: 'Scarica il file JSON',
    up_erase_h: 'Elimina NVS',
    up_erase_txt: 'Cancella tutta la memoria NVS: i coefficienti di calibrazione dei 5 canali (che tornano ai valori nominali) e le impostazioni salvate dal sistema; il PIN di servizio resta. Fare prima la copia dei coefficienti.',
    up_erase_type: 'Per confermare scrivere ELIMINA',
    up_erase_btn: 'ELIMINA NVS E RIAVVIA',
    up_erase_confirm: 'Eliminare definitivamente la NVS? Le calibrazioni andranno perse.',
    up_erased: 'NVS eliminata, strumento riavviato.',
    up_i_safe_k: 'Sicurezza',
    up_i_safe: 'Durante l\'aggiornamento le uscite vengono spente e il LED lampeggia magenta; una calibrazione in corso blocca l\'aggiornamento.',
    up_i_slots_k: 'Due Partizioni',
    up_i_slots: 'Il nuovo firmware si scrive nella partizione libera (app0 / app1) e diventa attivo solo se completo e verificato: se l\'invio si interrompe resta quello attuale.',
    up_i_keep_k: 'Cosa Resta',
    up_i_keep: 'Le calibrazioni (NVS) restano dopo l\'aggiornamento del firmware e dell\'interfaccia.',
    up_i_app_k: 'App Android',
    up_i_app: 'Durante il riavvio l\'app mostra "Collegamento perso" e si ricollega da sola.',
    up_i_fail_k: 'In Caso di Problemi',
    up_i_fail: 'Se il nuovo firmware non parte, ricaricarlo via USB: pio run -e esp32-s3fn8 -t upload.',
    fn_bench: 'Collaudo',
    bt_title: 'Collaudo',
    bt_sub: 'Banco di Prova Tecnico',
    bt_st_off: 'USCITE SPENTE',
    bt_st_on: 'USCITA ATTIVA',
    bt_st_fault: 'FAULT',
    bt_warn: 'Pagina tecnica: le uscite qui non usano la calibrazione. Per l\'uso normale scegliere le pagine Genera.',
    bt_out: 'Uscite Senza Calibrazione',
    bt_set: 'IMPOSTA',
    bt_rb: 'Rilettura AD5412',
    bt_k_mode: 'Modo',
    bt_k_theory: 'Valore Teorico',
    bt_m_off: 'Spenta',
    bt_m_v: 'Tensione 0–10 V',
    bt_m_i: 'Corrente 4–20 mA',
    bt_m_s: 'Corrente 2F (sink)',
    bt_out_hint: 'Codice DAC dal valore nominale (tensione 10 V × D / 4096, corrente 4 mA + 16 mA × D / 4096, AD5412 Tab. 17 ed eq. 2 e 6). Tensione: carico ≥ 1 kΩ. Corrente: carico ≤ circa 950 Ω a 20 mA. 2F: loop alimentato dall\'esterno su P1.2 SIM+ / P1.1 COM; con il sink attivo anche P1.4 V+ è in tensione. Le uscite si spengono se nessun dispositivo resta collegato al WiFi.',
    bt_in: 'Ingressi ADS1220',
    bt_v_nom: 'Tensione Nominale',
    bt_i_nom: 'Corrente Nominale',
    bt_cal_val: 'Calibrata: {v}',
    bt_k_vrng: 'Tensione Min … Max',
    bt_k_irng: 'Corrente Min … Max',
    bt_k_flags: 'Fuori Scala / Negativa',
    bt_k_att: 'Attenuazione ADC (GPIO1)',
    bt_k_g17: 'GPIO17 · Presenza 24 V',
    bt_k_g18: 'GPIO18 · Presenza 5 V',
    bt_high: 'ALTO',
    bt_low: 'BASSO',
    bt_led: 'LED',
    bt_rgb_apply: 'MOSTRA PER 60 s',
    bt_rgb_auto: 'TORNA AUTOMATICO',
    bt_led_test: 'LED di test blu (GPIO36)',
    bt_on: 'ACCESO',
    bt_off: 'SPENTO',
    bt_dur: 'Durata',
    bt_cont: 'CONTINUO',
    bt_more: 'Test SPI e Antenna',
    bt_more_txt: 'Test di scrittura e rilettura di AD5412 e ADS1220, potenza TX, segnale dei dispositivi e reti vicine sono nella pagina Diagnostica.',
    bt_more_btn: 'APRI DIAGNOSTICA',
    sc_in_title: 'Scalatura Ingresso',
    sc_in_sub: 'Misura in Unità Ingegneristiche',
    sc_out_title: 'Pannello Operatore',
    sc_out_sub: 'Comando in % o in Unità Ingegneristiche',
    sc_value: 'Valore scalato',
    sc_now: 'Uscita attuale',
    sc_cmd_off: 'Comando (uscita spenta)',
    sc_pct: '{p} % della scala',
    sc_under: 'Sotto scala',
    sc_over: 'Sopra scala',
    sc_cmd_pct: 'Comando in %',
    sc_cmd_eng: 'Comando in Unità',
    sc_elec: 'Segnale da generare: {v}',
    sc_cmd_hint: 'Con l\'uscita attiva il comando si applica subito; a uscita spenta prepara il valore e si attiva con ATTIVA.',
    sc_range: 'Campo del segnale',
    sc_zero: 'Zero',
    sc_zero_h: '(Valore a 0 %)',
    sc_span: 'Span',
    sc_span_h: '(Valore a 100 %)',
    sc_unit: 'Unità',
    sc_dec: 'Decimali',
    fn_pid: 'Simulatore di Processo',
    hm_pd_sub: 'Prova il PID del PLC',
    out_sim: 'Simulatore di processo attivo',
    bt_m_i24: 'Corrente 0–24 mA (Simulatore)',
    pd_title: 'Simulatore di Processo',
    pd_idle: 'Premi AVVIA: qui vedrai uscita del PLC, valvola e sensore',
    pd_go_s: 'AVVIA',
    pd_stop_s: 'FERMA',
    pd_tab_dist: 'Disturbi',
    pd_tab_proc: 'Processo',
    pd_tab_wire: 'Collega',
    pd_tab_pid: 'PID',
    pd_osc: 'Oscillazione',
    pd_sensor: 'Sensore',
    pd_m_integ_s: 'Livello',
    pd_m_first_s: '1° Ordine',
    pd_m_second_s: '2° Ordine',
    pd_dacfault: 'Allarme reale: il loop del sensore verso l\'ingresso AI è aperto (P1.3 mA+ / P1.1 COM). Collegare l\'AI del PLC o controllarne la configurazione (trasmettitore a 4 fili).',
    pd_pre_flow_s: 'Veloce · T 2 s',
    pd_pre_press_s: 'Media · T 5 s',
    pd_pre_temp_s: 'Lenta · T 60 s',
    pd_pre_level_s: 'Integratore',
    pd_cf_t: 'Avviare la Simulazione?',
    pd_cf_proc: 'Processo',
    pd_cf_out: 'Sensore → PLC',
    pd_cf_in: 'PLC → IO Tester',
    pd_cf_hint: 'Controlla i 4 fili e la configurazione AI/AO del PLC. Le uscite si attivano subito.',
    pd_cf_wire: 'VEDI COLLEGAMENTO',
    pd_sub: 'Prova il PID del PLC su un Processo Simulato',
    pd_st_stop: 'FERMO',
    pd_st_run: 'IN SIMULAZIONE',
    pd_live: 'Simulazione',
    pd_v_mv: 'Uscita PLC (MV)',
    pd_v_valve: 'Valvola',
    pd_v_sim: 'Simulata',
    pd_v_pv: 'Sensore (PV)',
    pd_mvbad: 'Uscita del PLC assente o fuori campo: controllare i fili 3 e 4 e che il PID sia in automatico.',
    pd_fault_on: 'Guasto simulato: {f} (per il PLC è un guasto vero del sensore)',
    pd_lg_mv: 'Uscita PLC',
    pd_lg_vl: 'Valvola',
    pd_lg_pv: 'Sensore',
    pd_chk: 'Collegamento fatto e ingresso/uscita del PLC configurati come nel disegno',
    pd_go: 'AVVIA SIMULAZIONE',
    pd_stop: 'FERMA SIMULAZIONE',
    pd_dist_t: 'Disturbi e Guasti',
    pd_dist_sub: 'Applicati Subito',
    pd_load: 'Disturbo di Carico',
    pd_amp: 'Oscillazione',
    pd_period: 'Periodo',
    pd_noise: 'Rumore del Sensore',
    pd_drift: 'Deriva del Sensore',
    pd_fault: 'Guasto del Sensore',
    pd_f0: 'Normale',
    pd_f1: 'Filo Rotto',
    pd_f2: 'Guasto Basso',
    pd_f3: 'Guasto Alto',
    pd_f4: 'Congelato',
    pd_fault_hint_i: 'Filo rotto: uscita aperta (0 mA). Guasto basso 3,6 mA e alto 21 mA (NAMUR NE 43; 0 mA nel campo 0–20). Congelato: il valore resta fermo mentre il processo cambia.',
    pd_fault_hint_v: 'Filo rotto: uscita aperta. Guasto basso 0 V, alto 10 V. Congelato: il valore resta fermo mentre il processo cambia.',
    pd_pid_t: 'PID Suggerito',
    pd_pid_sub: 'Punto di Partenza per PID_Compact',
    pd_kc: 'Guadagno',
    pd_ti: 'Tempo Integrale Ti',
    pd_td: 'Tempo Derivativo Td',
    pd_cycle: 'Ciclo OB Consigliato',
    pd_pid_hint: 'Regole SIMC con τc pari al tempo morto efficace (tempo morto + 10% del tempo di corsa): regolazione rapida e senza oscillazioni sul modello ideale. Con PV e uscita in % il guadagno è adimensionale. Verifica e affina sul PLC.',
    pd_proc_t: 'Processo',
    pd_proc_sub: 'Valvola e Processo Simulati',
    pd_presets: 'Processi Tipici',
    pd_pre_flow: 'Portata',
    pd_pre_press: 'Pressione',
    pd_pre_temp: 'Temperatura',
    pd_pre_level: 'Livello',
    pd_model: 'Modello',
    pd_m_first: 'Primo Ordine',
    pd_m_second: 'Secondo Ordine',
    pd_m_integ: 'Livello (Integratore)',
    pd_m_hint_0: 'Risposta a esponenziale dopo il tempo morto: portate, pressioni, molti processi semplici.',
    pd_m_hint_1: 'Due ritardi in serie e tempo morto: temperature, scambiatori, processi lenti.',
    pd_m_hint_2: 'Il livello sale o scende finché ingresso e uscita non si equilibrano: senza regolazione il serbatoio si svuota o trabocca.',
    pd_gain: 'Guadagno',
    pd_t1: 'Costante di Tempo T',
    pd_t2: 'Seconda Costante T2',
    pd_dead: 'Tempo Morto',
    pd_pv0: 'PV a Valvola Chiusa',
    pd_tfill: 'Tempo di Riempimento',
    pd_outflow: 'Portata in Uscita',
    pd_valve: 'Valvola Simulata',
    pd_stroke: 'Tempo di Corsa',
    pd_db: 'Banda Morta',
    pd_lin: 'Lineare',
    pd_eqp: 'Equipercentuale',
    pd_reset: 'RIPARTI DA ZERO',
    pd_sig_t: 'Segnali e Collegamento',
    pd_in: 'Uscita del PLC (MV) → Ingresso P2',
    pd_out: 'Sensore Simulato (PV) → Ingresso del PLC',
    pd_wr_ai: 'Ingresso Analogico',
    pd_wr_ao: 'Uscita Analogica',
    pd_wr_pv: 'Sensore (PV)',
    pd_wr_mv: 'Uscita PID (MV)',
    pd_wr_note: 'In TIA Portal: ingresso AI come trasmettitore a 4 fili (o tensione), uscita AO in corrente o tensione come scelto sopra. IO Tester legge l\'uscita del PLC ogni 50 ms e aggiorna il sensore ogni 50 ms.',
    pd_wr_note_sink: 'Sensore a 2 fili: l\'ingresso AI del PLC è configurato come trasmettitore a 2 fili e alimenta il loop; IO Tester regola la corrente come un vero trasmettitore.',
    pd_info: 'Come Usarlo con TIA Portal',
    pd_i1_k: '1. Hardware',
    pd_i1: 'Configura un canale AI (misura) e un canale AO (comando) con i tipi scelti in Segnali; collega i 4 fili del disegno.',
    pd_i2_k: '2. PID_Compact',
    pd_i2: 'Richiama PID_Compact in un OB di schedulazione orologio (OB30) con ciclo almeno 10 volte più corto della costante di tempo. Input_PER = canale AI, Output_PER = canale AO.',
    pd_i3_k: '3. Scalatura',
    pd_i3: 'Nella configurazione del PID scala l\'ingresso 0…27648 → 0…100 % (per 4–20 mA, valore raw S7). Così PV, setpoint e uscita sono tutti in %.',
    pd_i4_k: '4. Avvio',
    pd_i4: 'Premi AVVIA in basso, poi metti il PID in automatico e dai un setpoint: nel grafico vedi uscita del PLC, valvola e sensore. Puoi anche lanciare l\'ottimizzazione automatica di PID_Compact.',
    pd_i5_k: '5. Disturbi',
    pd_i5: 'Prova la reazione del regolatore con disturbi di carico, oscillazioni, rumore e deriva; prova la diagnostica con i guasti del sensore (filo rotto, NAMUR).',
    pd_i6_k: 'Sicurezza',
    pd_i6: 'LED viola durante la simulazione; il rosso lampeggiante indica solo un allarme reale (loop del sensore aperto). La simulazione si ferma e le uscite si spengono se il telefono si scollega dal WiFi, con SPEGNI USCITE, durante calibrazioni e aggiornamenti.',
    grp_test: 'Prove',
    fn_tests: 'Prove Guidate',
    hm_pg_sub: 'Convertitori, isolatori, valvole',
    pg_title: 'Prove Guidate',
    pg_sub: 'Genera, Misura e Confronta',
    pg_type: 'Tipo di Prova',
    pg_m_conv: 'Convertitore / Isolatore',
    pg_m_valve: 'Valvola / Posizionatore',
    pg_stim: 'Stimolo (uscita P1)',
    pg_resp: 'Risposta del dispositivo (ingresso P2)',
    pg_cmd: 'Comando al posizionatore (uscita P1)',
    pg_fb: 'Ritorno di posizione (ingresso P2)',
    pg_vstep: 'Ampiezza dei gradini',
    pg_tol: 'Tolleranza',
    pg_settle: 'Attesa per Punto',
    pg_vtimeout: 'Tempo Max per Gradino',
    pg_down: 'Anche in discesa (isteresi)',
    pg_chk: 'Ho collegato i fili come nel disegno e alimentato il dispositivo',
    pg_go_conv: 'AVVIA PROVA CONVERTITORE',
    pg_go_valve: 'AVVIA PROVA A GRADINI',
    pg_go_db: 'MISURA BANDA MORTA',
    pg_res: 'Risultati',
    pg_res_empty: 'I risultati compaiono qui durante la prova. Le uscite si spengono alla fine o premendo INTERROMPI.',
    pg_trend: 'Comando e posizione (ultimi 2 minuti)',
    pg_chart: 'Errore per punto (% del campo)',
    pg_lg_cmd: 'Comando',
    pg_lg_pos: 'Posizione',
    pg_lg_up: 'Salita',
    pg_lg_dn: 'Discesa',
    pg_lg_tol: 'Tolleranza',
    pg_th_out: 'Stimolo',
    pg_th_exp: 'Atteso',
    pg_th_read: 'Letto',
    pg_th_err: 'Errore',
    pg_th_cmd: 'Comando',
    pg_th_pos: 'Posizione',
    pg_timeout: 'Tempo scaduto',
    pg_copy: 'COPIA RISULTATI',
    pg_ok: 'DENTRO TOLLERANZA',
    pg_ko: 'FUORI TOLLERANZA',
    pg_r_errmax: 'Errore Massimo',
    pg_r_hyst: 'Isteresi',
    pg_r_tol: 'Tolleranza',
    pg_r_t90: 't90 Massimo',
    pg_r_db_up: 'Banda Morta in Salita',
    pg_r_db_dn: 'Banda Morta in Discesa',
    pg_r_base: 'Posizione a 50 %',
    pg_s_point: 'Punto {p} % ({k} di {n})…',
    pg_s_start: 'Porto la valvola a 0 %…',
    pg_s_vstep: 'Gradino a {p} % ({k} di {n})…',
    pg_s_db0: 'Porto la valvola a 50 %…',
    pg_s_db: 'Comando {c} %…',
    pg_live: 'Comando {c} % · posizione {p} %',
    pg_e_resp: 'Il dispositivo non risponde: atteso circa {x}, letti {r}. Controllare collegamento e alimentazione del dispositivo.',
    pg_e_fb: 'Ritorno di posizione anomalo a 0 % ({p} %): controllare collegamento e taratura del posizionatore.',
    pg_dev_conv: 'Dispositivo in prova',
    pg_dev_valve: 'Posizionatore',
    pg_pow_own: 'Alimentato a parte',
    pg_pow_loop: 'Uscita alimentata da L+',
    pg_cmd_p: 'COMANDO +',
    pg_cmd_m: 'COMANDO −',
    pg_fb_p: 'RITORNO +',
    pg_fb_m: 'RITORNO −',
    pg_wr_conv: 'Ingresso del dispositivo su P1, uscita del dispositivo su P2. Il dispositivo va alimentato con la sua alimentazione. P1 e P2 sono isolati tra loro: adatti anche alla prova di isolatori.',
    pg_wr_conv2f: 'Ingresso del dispositivo su P1; la sua uscita a 2 fili è alimentata dallo strumento (P2.5 L+) e misurata su P2.4 mA+.',
    pg_wr_valve: 'Comando 4–20 mA su P1.3 mA+ / P1.1 COM; ritorno di posizione su P2 (2 fili alimentato da L+, oppure 4 fili). Aria di alimentazione del posizionatore aperta: la valvola si muove durante la prova.',
    pg_info: 'Come Funziona',
    pg_i_what_k: 'Prova',
    pg_i_conv_what: 'Lo strumento genera 0-25-50-75-100 % del campo scelto (anche in discesa), attende l\'assestamento e legge la risposta del dispositivo',
    pg_i_err_k: 'Errore',
    pg_i_conv_err: 'In % del campo d\'uscita del dispositivo; isteresi = differenza tra salita e discesa allo stesso punto. Tolleranza tipica di convertitori e isolatori: 0,1 – 0,5 %',
    pg_i_iso_k: 'Isolamento',
    pg_i_conv_iso: 'P1 (COM_OUT) e P2 (COM_IN) sono domini isolati: la prova funziona anche su isolatori galvanici e barriere',
    pg_i_valve_what: 'Gradini di comando su e giù; per ogni gradino attende la posizione stabile (2,5 s entro 0,2 %) e registra errore e tempo di risposta',
    pg_i_t90_k: 't90',
    pg_i_valve_t90: 'Tempo per percorrere il 90 % del gradino. Risoluzione circa 0,5 s: l\'ingresso fa la media di 10 letture (circa 1 s)',
    pg_i_db_k: 'Banda Morta',
    pg_i_valve_db: 'Da 50 % il comando sale a passi di 0,1 % ogni 3 s finché la posizione si muove di 0,25 %; poi lo stesso in discesa',
    pg_i_load_k: 'Carico',
    pg_i_valve_load: 'L\'uscita 4–20 mA regge fino a circa 950 Ω a 20 mA: sufficiente per i posizionatori (tipici 300 – 600 Ω, cioè 6 – 12 V)',
    al_title: 'Soglie e Allarme',
    al_sub: 'Nelle Unità della Scalatura',
    al_off: 'SPENTO',
    al_on: 'ATTIVO',
    al_lo: 'Soglia Bassa',
    al_hi: 'Soglia Alta',
    al_buzz: 'Cicalino dello Strumento',
    al_mute: 'TACITA',
    al_st_off: 'Allarme spento',
    al_st_ok: 'Normale',
    al_st_hi: 'ALLARME ALTO',
    al_st_lo: 'ALLARME BASSO',
    al_st_sat: 'ALLARME · FUORI SCALA',
    al_hint: 'Una soglia vuota non viene controllata. Isteresi dell\'1% della scala per evitare allarmi intermittenti. Il cicalino suona ogni secondo finché dura l\'allarme o finché si tacita; funziona con la pagina aperta.',
    fn_autotest: 'Autotest',
    hm_at_sub: 'Verifica dello strumento in 1 minuto',
    at_title: 'Autotest',
    at_sub: 'Verifica dello Strumento in Circa 1 Minuto',
    at_wr_main: 'Collegamento principale · 4 fili',
    at_wr_sink: 'Prova del 2F · 2 fili',
    at_w1: 'Rosso: P1.4 V+ → P2.2 V+ (tensione)',
    at_w2: 'Blu: P1.3 mA+ → P2.4 mA+ (corrente)',
    at_w3: 'Nero: P1.1 COM → P2.1 V− (comune)',
    at_w4: 'Ponticello nero: P2.1 V− → P2.3 mA− (comune della corrente)',
    at_w5: 'Rosso: P2.5 L+ → P1.2 SIM+',
    at_w6: 'Nero: P1.1 COM → P2.4 mA+',
    at_wr_note_main: 'Quattro fili, sempre gli stessi: conviene preparare un connettore di prova. Il filo blu passa sopra il rosso, non si toccano. P1.2 SIM+ e P2.5 L+ restano liberi.',
    at_wr_note_sink: 'Togliere TUTTI i fili del collegamento principale, poi collegare solo questi due. Lo strumento alimenta il loop da L+ e misura la corrente del sink.',
    at_info: 'Cosa Controlla',
    at_i_spi_k: 'Chip',
    at_i_spi: 'Scrittura e rilettura dei registri di AD5412 e ADS1220 attraverso gli isolatori',
    at_i_v_k: 'Tensione',
    at_i_v: 'Uscita a 1, 5 e 9 V riletta dall\'ingresso tensione, più il rumore',
    at_i_i_k: 'Corrente',
    at_i_i: 'Uscita a 4, 12 e 20 mA riletta dall\'ingresso corrente, più rumore e FAULT; poi uscite spente (≈ 0)',
    at_i_s_k: '2F (Facoltativo)',
    at_i_s: 'Sink a 4, 12 e 20 mA alimentato da L+, con il secondo collegamento',
    at_i_lim_k: 'Limiti',
    at_i_lim: 'Tensione ±10 mV (0,1% di 10 V) · corrente ±30 µA (0,15% di 20 mA) · 2F ±50 µA · rumore ≤ 1 mV / 2 µA: metà dell\'obiettivo ±0,3%. Al collaudo: ±2 mV, entro 20 µA',
    at_i_when_k: 'Quando Farlo',
    at_i_when: 'Prima di andare in impianto, dopo un errore di collegamento in campo e periodicamente per controllare la deriva',
    at_run: 'Prova',
    at_run_sub: 'Valori Calibrati, Lettura dagli Ingressi',
    at_chk_wire: 'Ho collegato i fili come nel disegno',
    at_chk_free: 'Nessun altro dispositivo collegato a P1 e P2',
    at_go: 'AVVIA AUTOTEST',
    at_go_s: 'AVVIA PROVA DEL 2F',
    at_sink_btn: 'PROVA ANCHE IL 2F (SECONDO COLLEGAMENTO)',
    at_back_btn: 'TORNA AL COLLEGAMENTO PRINCIPALE',
    at_th_test: 'Prova',
    at_th_exp: 'Atteso',
    at_th_read: 'Letto',
    at_th_lim: 'Limite',
    at_s_spi: 'Test dei chip…',
    at_s_wire_v: 'Controllo del collegamento della tensione…',
    at_s_wire_i: 'Controllo del collegamento della corrente…',
    at_s_wire_s: 'Controllo del collegamento del 2F…',
    at_s_v: 'Tensione {x} V…',
    at_s_i: 'Corrente {x} mA…',
    at_s_s: '2F {x} mA…',
    at_s_off: 'Uscite spente…',
    at_r_spi_dac: 'Chip AD5412 (uscite)',
    at_r_spi_adc: 'Chip ADS1220 (ingressi)',
    at_r_v: 'Tensione {x} V',
    at_r_i: 'Corrente {x} mA',
    at_r_s: '2F {x} mA',
    at_r_vnoise: 'Rumore tensione',
    at_r_inoise: 'Rumore corrente',
    at_r_fault: 'FAULT AD5412',
    at_r_off: 'Uscite spente',
    at_e_wire_v: 'Collegamento della tensione mancante: a {x} l\'ingresso legge {r}. Controllare i fili 1 (rosso) e 3 (nero).',
    at_e_wire_i: 'Collegamento della corrente mancante: a {x} l\'ingresso legge {r}. Controllare il filo 2 (blu) e il ponticello 4.',
    at_e_wire_s: 'Collegamento del 2F mancante: a {x} l\'ingresso legge {r}. Controllare i fili 5 e 6 e che gli altri siano tolti.',
    at_e_adc: 'L\'ADS1220 non aggiorna le misure.',
    at_aborted: 'Autotest interrotto.',
    at_ok: 'STRUMENTO OK',
    at_ko: 'DA CONTROLLARE',
    at_n_ok: '{a} di {b} prove superate',
    at_limit_note: 'L\'autotest confronta le uscite con gli ingressi dello strumento: trova guasti e derive, ma non sostituisce la verifica con uno strumento di riferimento esterno.',
    pin_panel: 'PIN di Servizio',
    pin_panel_sub: 'Protegge Aggiornamenti, Calibrazione ed Elimina NVS',
    pin_state: 'Stato',
    pin_is_default: 'Predefinito (1234): cambiarlo',
    pin_is_custom: 'Personalizzato',
    pin_old: 'PIN Attuale',
    pin_new: 'Nuovo PIN (4–8 Cifre)',
    pin_new2: 'Ripeti il Nuovo PIN',
    pin_change: 'CAMBIA PIN',
    pin_changed: 'PIN cambiato.',
    pin_mismatch: 'I due nuovi PIN non coincidono.',
    pin_format: 'Il PIN deve avere da 4 a 8 cifre.',
    pin_bad: 'PIN errato.',
    pin_locked: 'Troppi tentativi errati: riprovare tra {s} s.',
    pin_title: 'PIN di Servizio',
    pin_ok: 'CONFERMA',
    pin_for_fw: 'Inserire il PIN per aggiornare il firmware.',
    pin_for_fs: 'Inserire il PIN per aggiornare l\'interfaccia.',
    pin_for_nvs: 'Inserire il PIN per eliminare la NVS.',
    pin_for_cal: 'Inserire il PIN per salvare la calibrazione.',
    pin_for_cal_clear: 'Inserire il PIN per cancellare la calibrazione.',
    sc_unit_free: 'Nessuna unità in elenco: si usa il testo scritto',
    sc_g_pct: 'Percentuale',
    sc_g_press: 'Pressione',
    sc_g_temp: 'Temperatura',
    sc_g_flow: 'Portata',
    sc_g_level: 'Livello e distanza',
    sc_g_mass: 'Peso',
    sc_g_speed: 'Velocità e frequenza',
    sc_g_elec: 'Elettriche',
    sc_g_chem: 'Analisi e umidità',
    sc_err_span: 'Zero e span devono essere diversi.',
    bt_m_i0: 'Corrente 0–20 mA',
    gi_title: 'Genera Corrente 4F',
    gi_sub: '4–20 / 0–20 mA · Uscita Attiva Isolata',
    rb_loop_hint_i: 'Solo collegando P1.3 mA+ → P2.4 mA+ e P1.1 COM → P2.3 mA−',
    wr_plc_sub_i: 'PLC · 4–20 mA passivo',
    wr_note_i: 'Collegare solo P1.3 mA+ e P1.1 COM. P1.2 SIM+ e P1.4 V+ restano liberi. L\'ingresso del PLC deve essere passivo (4 fili): se è un ingresso che alimenta il loop usare "Genera Corrente 2F". Il multimetro, se serve, va in serie.',
    i_range_i: '4 – 20 mA (massimo 19,996 mA) oppure 0 – 20 mA (massimo 19,995 mA; linearità garantita da 78 µA, AD5412 Tab. 2 nota 4)',
    i_res_i: '3,91 µA · 12 bit',
    i_acc_i: '±0,08% del campo a 25 °C (offset ±0,03% + guadagno ±0,05%, AD5412 Tab. 2, RSET esterno) · misurata −0,11% in loopback',
    i_load_i: 'Massimo circa 950 Ω a 20 mA (compliance AVDD − 2,5 V, AD5412 Tab. 2, meno le resistenze di protezione)',
    i_open_k: 'Circuito Aperto',
    i_open_i: 'Rilevato dall\'AD5412: FAULT e avviso nella pagina',
    i_iso_i: 'Uscita isolata: P1.1 COM è separato dalla massa dello strumento',
    i_safe_i: 'Si spegne da sola se il dispositivo si scollega dal WiFi; non collegare a sorgenti di tensione o a ingressi che alimentano il loop',
  },
  en: {
    brand_sub: 'Analog I/O calibrator',
    conn_wait: 'Connecting…',
    conn_ok: 'Connected',
    conn_lost: 'Connection lost',
    cmd_fail: 'Command failed',
    theme: 'Light / dark theme',

    out_v: 'Voltage output active: {v} V',
    out_i: 'Current output active: {v} mA',
    out_sink: 'Current output 2W active: {v} mA',
    out_fault: '⚠ AD5412 FAULT: check the wiring',
    btn_off: 'SWITCH OUTPUTS OFF',

    live_title: 'Live readings',
    live_hint: 'Updated every second',
    in_voltage: 'Voltage Input',
    in_current: 'Current Input',
    output: 'Output',
    out_off: 'Off',
    out_off_sub: 'No active output',
    mode_v: 'Voltage 0–10 V',
    mode_i: 'Current 4–20 mA',
    mode_sink: '2-wire sink',
    range_minmax: 'Min {min} · max {max}',
    flag_over: 'OVER-RANGE',
    flag_neg: 'POLARITY?',
    flag_fault: 'FAULT',

    grp_gen: 'Generate',
    grp_meas: 'Measure',
    grp_loop: '2-Wire Transmitters',
    grp_tool: 'Instrument',
    fn_voltage: 'Voltage',
    fn_current: 'Current 4W',
    fn_sim: 'Current 2W',
    fn_sim_range: '4 – 20 mA passive · 2-wire',
    fn_cur_active: '4 – 20 mA active',
    fn_cur_4w: 'Current 4W',
    fn_cur_4w_range: '4 – 20 mA · active source',
    fn_cur_2w: 'Current 2W',
    fn_cur_2w_range: '4 – 20 mA · powered by L+ 24 V',
    w4: '4-wire',
    w2: '2-wire',
    fn_power: 'Power and Measure',
    fn_cal: 'Calibration',
    fn_cal_range: '5 channels',
    fn_diag: 'Diagnostics',
    fn_diag_range: 'Test and checks',
    soon: 'Soon',

    sys_title: 'System status',
    sec_supply: 'Power Supply',
    sec_out: 'Output · AD5412',
    sec_in: 'Input · ADS1220',
    sec_esp: 'Controller · ESP32-S3',
    sec_wifi: 'WiFi',
    sec_cal: 'Calibration',
    k_source: 'Source',
    k_vusb: 'USB Voltage',
    k_ext24: '24 V Input',
    k_ext5: '5 V Input',
    k_state: 'State',
    k_selftest: 'Boot Test',
    k_fault: 'FAULT',
    k_overtemp: 'Over-Temperature',
    k_temp: 'Temperature',
    k_conv: 'Conversions',
    k_errors: 'Errors',
    k_heap: 'Free Memory',
    k_heap_min: 'Minimum Memory',
    k_uptime: 'Running for',
    k_reset: 'Last Restart',
    k_network: 'Network',
    k_channel: 'Channel',
    k_tx: 'TX Power',
    k_clients: 'Devices',
    k_rssi: 'Signal',
    cal_sink: '2-wire sink',
    cal_vout: 'Voltage output',
    cal_iout: 'Current output',
    cal_vin: 'Voltage input',
    cal_iin: 'Current input',

    v_usb: 'USB / power bank',
    v_field: '24 V field supply',
    v_present: 'Present',
    v_absent: 'Absent',
    v_ok: 'OK',
    v_failed: 'FAILED',
    v_no: 'No',
    v_yes: 'YES',
    v_off: 'Off',
    v_none: 'Not calibrated',
    v_low: 'Low',
    rst_poweron: 'Power-on',
    rst_sw: 'Software / OTA',
    rst_panic: 'Firmware error',
    rst_wdt: 'Watchdog',
    rst_brownout: 'Brown-out',
    rst_deepsleep: 'Wake-up',
    rst_ext: 'Reset button',
    rst_other: 'Other',

    footer_diag: 'Technical diagnostics',

    // Pagina "Genera Tensione" / "Generate Voltage" page
    nav_home: 'Home',
    nav_menu: 'Menu',
    nav_close: 'Close menu',
    gv_title: 'Generate Voltage',
    gv_sub: '0 – 10 V · Isolated Output',
    st_on: 'ON',
    st_off: 'OFF',
    st_other: 'ANOTHER OUTPUT ON',
    sp_title: 'Setpoint',
    sp_now: 'Current output',
    sp_label: 'Value to generate',
    sp_quick: 'Quick values',
    sp_step: 'Fine adjustment',
    btn_enable: 'ENABLE OUTPUT',
    btn_enable_s: 'ENABLE SIMULATION',
    btn_apply: 'APPLY',
    btn_apply_v: 'APPLY {v} {u}',
    btn_stop: 'SWITCH OFF',
    sp_hint: 'Quick values and fine adjustment apply immediately. A typed value is confirmed with APPLY or the Enter key.',
    sp_err: 'Out of range: {min} – {max} {u}',
    sp_switch: 'Enabling this output will switch the other active output off.',
    rb_title: 'Technical Details',
    rb_sub: 'AD5412 Chip Read-Back',
    rb_expected: 'Expected Value',
    rb_nominal: 'Nominal Value',
    rb_code: 'DAC Code Written / Read Back',
    rb_ctrl: 'Control Register',
    rb_cal: 'Output Calibration',
    rb_loop: 'Check on Input {p}',
    rb_loop_hint_v: 'Only when wiring P1.4 V+ → P2.2 V+ and P1.1 COM → P2.1 V−',
    rb_delta: 'Deviation {d} {u}',
    cal_yes: 'Calibrated on {d}',
    wr_title: 'Wiring',
    wr_cal: 'IO Tester · P1 OUTPUT',
    wr_plc: 'Analog Input',
    wr_plc_sub_v: 'PLC · 0 – 10 V',
    wr_free: 'Free',
    wr_note_v: 'Connect only P1.4 V+ and P1.1 COM. P1.2 SIM+ and P1.3 mA+ stay free. A multimeter, if needed, goes in parallel with the PLC terminals.',
    in_title: 'Measurement Information',
    i_range_k: 'Range',
    i_range_v: '0 – 10 V (maximum 9.9976 V)',
    i_res_k: 'Resolution',
    i_res_v: '2.44 mV · 12 bit',
    i_acc_k: 'Accuracy',
    i_acc_v: '±0.1% of full scale at 25 °C (AD5412, Table 2) · measured ±0.02% in loopback',
    i_load_k: 'Load',
    i_load_v: 'Minimum 1 kΩ; recommended ≥ 10 kΩ (typical PLC inputs ≥ 100 kΩ)',
    i_short_k: 'Short Circuit',
    i_short_v: 'Current limited to about 17–20 mA (AD5412, Table 2), no damage',
    i_iso_k: 'Isolation',
    i_iso_v: 'Isolated output: P1.1 COM is separate from the instrument ground',
    i_safe_k: 'Safety',
    i_safe_v: 'Switches off by itself if the device leaves the WiFi; do not connect to voltage sources',
    fault_v: 'AD5412 FAULT: possible over-temperature, check the load on P1.4 V+ / P1.1 COM',
    fault_i: 'Open circuit or load too high: check the wiring on P1.3 mA+ / P1.1 COM',
    // Pagina "Genera Corrente 4F" / "Generate Current 4W" page
    fault_s: 'AD5412 FAULT (overtemperature): switch off and check the wiring',
    si_title: 'Generate Current 2W',
    si_sub: '4 – 20 mA Passive · 2-Wire, Loop Powered by the PLC',
    sp_namur: 'Out of range and failure (NAMUR NE 43)',
    rb_loop_hint_s: 'Only when wiring P2.5 L+ → P1.2 SIM+ and P1.1 COM → P2.4 mA+',
    wr_plc_sub_s: 'PLC · 4–20 mA, 2-wire',
    wr_note_s: 'The PLC powers the loop: its channel supply output (L+ or M+, depending on the module) goes to P1.2 SIM+, its measuring input to P1.1 COM. P1.3 mA+ and P1.4 V+ stay free. A multimeter, if needed, goes in series.',
    i_range_s: '0 – 22 mA (4 – 20 mA and NAMUR NE 43 values)',
    i_res_s: '5.84 µA · 12 bit (2.391 mA/V from divider R19/R20 on R16 25.5 Ω)',
    i_acc_s: '±0.21% of 16 mA after calibration (test phase 7) · drift up to ±0.19% over ±25 °C (R16, R19, R20 1%, 75 ppm/°C)',
    i_vloop_k: 'Loop Voltage',
    i_vloop_s: '24 V typical, 30 V maximum (D8 SMAJ33CA, V_RWM 33 V) · at 20 mA Q2 dissipates up to 0.5 W',
    i_open_s: 'Not detected by the instrument: the PLC reports it as wire break',
    i_rev_k: 'Reverse Polarity',
    i_rev_s: 'Protected by D6: 0 mA current, no damage (test 8.1)',
    i_iso_s: 'Isolated: P1.1 COM is separate from the instrument ground · P1.4 V+ carries the control voltage (0 – 9.2 V)',
    i_safe_s: 'Hardware interlock Q1: sink blocked at power-up and when the device leaves the WiFi',
    mv_title: 'Measure Voltage',
    mv_sub: '0 – 10 V · Isolated Input',
    ms_title: 'Measurement',
    ms_ok: 'MEASURING',
    ms_nosig: 'NO SIGNAL',
    ms_sat: 'OVER-RANGE',
    ms_neg: 'NEGATIVE',
    ms_hold: 'HOLD',
    ms_pct: '{p} % of range',
    ms_sat_v: 'Over-range: voltage above 20.6 V. Check the signal and the wiring.',
    ms_neg_v: 'Negative voltage: swap the wires on P2.2 V+ and P2.1 V−. Negative voltages cannot be measured.',
    btn_hold: 'HOLD',
    btn_resume: 'RESUME',
    btn_reset_stats: 'RESET STATISTICS',
    ms_stats: 'Statistics',
    ms_stats_sub: 'Since the Page Was Opened or Reset',
    ms_min: 'Minimum',
    ms_max: 'Maximum',
    ms_mean: 'Mean',
    ms_sd: 'Standard Deviation',
    ms_pp: 'Peak-to-Peak',
    ms_n: 'Samples · Duration',
    ms_trend: 'Trend · Last 2 Minutes',
    ms_now: 'Now',
    ms_rb_sub: 'Reading from the ADS1220 Chip',
    ms_nom: 'Value with Nominal Components',
    ms_win: 'Peak-to-Peak Noise (Last 10 Readings)',
    ms_code: 'ADC Code (24 Bit)',
    ms_satk: 'Over-Range',
    ms_cal: 'Input Calibration',
    ms_temp: 'ADS1220 Temperature',
    ms_conv: 'Conversions / Errors',
    ms_cmp: 'Comparison with Output {p}',
    ms_cmp_off: 'Output not active',
    ms_cmp_hint_v: 'Only when wiring P1.4 V+ → P2.2 V+ and P1.1 COM → P2.1 V− with "Generate Voltage" on',
    nm_low_fail: 'Failure: below 3.6 mA',
    nm_under: 'Under-range: 3.6 – 3.8 mA',
    nm_ok: 'Within measuring range',
    nm_over: 'Over-range: 20.5 – 21 mA',
    nm_high_fail: 'Failure: from 21 mA',
    wr_cal_in: 'IO Tester · P2 INPUT',
    wr_plc_out: 'Analog Output',
    wr_plc_sub_mv: 'PLC · 0–10 V',
    wr_note_mv: 'Connect the PLC output between P2.2 V+ and P2.1 V−; P2.3, P2.4 and P2.5 stay free. The PLC sees a 100.9 kΩ load. To check the instrument: P1.4 V+ → P2.2 V+ and P1.1 COM → P2.1 V− with "Generate Voltage".',
    i_range_mv: '0 – 10 V · reads up to 20.6 V (2.048 V × 10.09)',
    i_res_mv: '0.1 mV shown · input noise 39 µV rms, 135 µV peak-to-peak (ADS1220 Table 7-3: 3.89 µV rms at 20 SPS, PGA bypassed, × 10.09), reduced by averaging',
    i_acc_mv: 'Without calibration within ±0.25% (internal reference ±0.15%, ADS1220 §6.5; divider 0.05% + 0.05%; gain ±0.015%) · reference measured within 0.02% of the AD5412 one',
    i_zin_k: 'Input Impedance',
    i_zin_mv: '100.9 kΩ (90.9 kΩ + 10 kΩ, 0.05%): 99 µA at 10 V',
    i_rej_k: '50/60 Hz Rejection',
    i_rej_m: 'At least 90 dB at 20 SPS with the external 4.096 MHz oscillator (ADS1220 §6.5, NMRR)',
    i_upd_k: 'Update',
    i_upd_m: 'Moving average of 10 conversions (about 1 s), page refreshed every second',
    i_iso_mv: 'Isolated input: P2.1 V− is separate from the instrument ground and from P1.1 COM',
    i_safe_mv: 'Protected by SMAJ33CA + PPTC, tested at +24 V and −24 V (test 8.2, 8.3) · negative voltages cannot be measured',
    mi4_title: 'Measure Current 4W',
    mi4_sub: '4 – 20 mA · Active Source, Isolated Input',
    mi2_title: 'Measure Current 2W',
    mi2_sub: '4 – 20 mA · Transmitter Powered by L+ 24 V',
    wr_plc_sub_mi4: 'PLC · 4–20 mA active',
    wr_tx: 'Transmitter',
    wr_tx_sub: '2-wire · 4–20 mA',
    wr_note_mi4: 'Connect the active source between P2.4 mA+ (current flowing in) and P2.3 mA−; P2.1, P2.2 and P2.5 stay free. The source sees 27 – 41 Ω. To check the instrument: P1.3 mA+ → P2.4 mA+ and P1.1 COM → P2.3 mA− with "Generate Current 4W".',
    wr_note_mi2: 'The transmitter + goes to P2.5 L+, the − to P2.4 mA+; P2.1, P2.2 and P2.3 stay free. The instrument powers the loop and measures the current. To check the instrument: P2.5 L+ → P1.2 SIM+ and P1.1 COM → P2.4 mA+ with "Generate Current 2W".',
    ms_sat_i: 'Over-range: current above 40 mA. Check the wiring.',
    ms_neg_i4: 'Negative current: swap the wires on P2.4 mA+ and P2.3 mA−.',
    ms_neg_i2: 'Negative current: check the transmitter wiring.',
    ms_cmp_hint_i4: 'Only when wiring P1.3 mA+ → P2.4 mA+ and P1.1 COM → P2.3 mA− with "Generate Current 4W" on',
    ms_cmp_hint_i2: 'Only when wiring P2.5 L+ → P1.2 SIM+ and P1.1 COM → P2.4 mA+ with "Generate Current 2W" on',
    i_range_mi: '4 – 20 mA · reads up to 40.1 mA (1.024 V on 25.5 Ω shunt, gain 2)',
    i_res_mi: '0.1 µA shown · noise 0.07 µA rms, 0.27 µA peak-to-peak (ADS1220 Table 7-3: 1.85 µV rms at 20 SPS, gain 2, PGA bypassed, on 25.5 Ω), reduced by averaging',
    i_acc_mi: 'Without calibration within ±0.22% (internal reference ±0.15%, ADS1220 §6.5; shunt R34 0.05%; gain ±0.015%) · in loopback −0.11% versus the AD5412 output',
    i_burden_k: 'Voltage Drop',
    i_burden_mi4: '27 – 41 Ω (25.5 Ω shunt + PPTC): 0.54 – 0.81 V at 20 mA',
    i_lplus_k: 'L+ Supply',
    i_lplus_mi2: '23.9 V no-load (B0524S-2WR3), limited to 26.6 mA by LM317L + R28 47 Ω (test 8.9)',
    i_iso_mi: 'Isolated input: P2.3 mA− is separate from the instrument ground and from P1.1 COM',
    i_safe_mi4: 'Protected by SMAJ33CA + PPTC · do not connect a voltage directly between P2.4 mA+ and P2.3 mA−',
    i_safe_mi2: 'A short between P2.5 L+ and P2.4 mA+ is safe: current limited to 26.6 mA (test 8.9)',
    cal_title: 'Calibration',
    cal_sub: 'Inputs with a Reference Multimeter, Outputs in Loopback',
    cal_st_idle: 'READY',
    cal_st_run: 'IN PROGRESS',
    cal_chans: 'Channels',
    cal_order: 'Recommended Order: 1 → 5',
    cal_proc: 'Procedure',
    cal_info: 'About the Method',
    cal_pick: 'Choose a channel with CALIBRATE. Calibrate the inputs first (1, 2), but only with a multimeter of at least 4½ digits: the outputs (3 – 5) are compared with the inputs. With a less accurate multimeter calibrate the outputs only.',
    ch_vin: 'Voltage Input',
    ch_iin: 'Current Input',
    ch_vout: 'Voltage Output',
    ch_iout: 'Current Output 4W',
    ch_sink: 'Current Output 2W',
    cal_yes_t: 'Calibrated on {d} at {tc} °C',
    k_gain: 'Gain',
    k_offset: 'Offset',
    cal_m_in: 'Two points with a reference multimeter',
    cal_m_out: 'Automatic loopback, 5 points + check',
    btn_calibrate: 'CALIBRATE',
    btn_clear: 'CLEAR',
    cal_clear_confirm: 'Clear the calibration of "{n}"? The channel will return to nominal values.',
    dmm_v: 'Multimeter · V DC',
    dmm_ma: 'Multimeter · mA DC',
    wr_cal_vin: 'P1.4 V+ → P2.2 V+ and P1.1 COM → P2.1 V−; multimeter in V DC in parallel on P2.2 V+ / P2.1 V−. With an external source: connect it instead of P1.',
    wr_cal_iin: 'P1.3 mA+ → multimeter (mA) → P2.4 mA+; P2.3 mA− → P1.1 COM. With an external source: connect it instead of P1, still in series with the multimeter.',
    wr_cal_vout: 'P1.4 V+ → P2.2 V+ and P1.1 COM → P2.1 V−. No other load on P1.4 V+.',
    wr_cal_iout: 'P1.3 mA+ → P2.4 mA+ and P2.3 mA− → P1.1 COM.',
    wr_cal_sink: 'P2.5 L+ → P1.2 SIM+ and P1.1 COM → P2.4 mA+: L+ powers the loop and the input measures the current.',
    cal_in_intro_vin: 'Two points, about 1 V and 9 V. The instrument generates the voltage on P1.4 V+; the multimeter gives the true value, to be typed into the page.',
    cal_in_intro_iin: 'Two points, 4 mA and 20 mA. The instrument generates the current on P1.3 mA+; the series multimeter gives the true value, to be typed into the page.',
    cal_chk_warm: 'Instrument on for at least 15 minutes',
    cal_chk_dmm_vin: 'Multimeter in V DC, 10 V or auto range',
    cal_chk_dmm_iin: 'Multimeter in mA DC, lead in the mA socket',
    cal_chk_wiring: 'Wiring as in the diagram',
    cal_chk_free: 'No other connections on the terminals used',
    cal_ext: 'I use an external source instead of the instrument output',
    cal_dmm_warn: 'Multimeter with fewer than 4½ digits (e.g. 2 decimals) or accuracy worse than ±0.075%: do not calibrate the inputs, they would get worse. Calibrate the outputs only (3 – 5).',
    cal_dmm_ok: 'My multimeter has at least 4½ digits and ±0.075% accuracy or better',
    btn_start: 'START',
    btn_cancel: 'CANCEL',
    cal_point_h: 'Point {k} of 2: about {v} {u}',
    cal_point_ext: 'Apply about {v} {u} with the external source and wait for a stable reading.',
    cal_point_int_vin: 'The instrument generates about {v} {u} on P1.4 V+. Wait for a stable reading, then type the multimeter value.',
    cal_point_int_iin: 'The instrument generates about {v} {u} on P1.3 mA+. Wait for a stable reading, then type the multimeter value.',
    cal_live: 'Instrument reading (nominal values)',
    cal_ref_label: 'Value read on the multimeter',
    btn_confirm_pt: 'CONFIRM POINT {k}',
    cal_stable: 'Stable',
    cal_settling: 'Settling',
    cal_e_ref: 'The multimeter value is too far from the reading: check the unit ({u}) and the wiring.',
    cal_e_span: 'Points too close: at least {s} {u} apart are needed.',
    cal_e_limits: 'Coefficients out of limits (gain ±5% or offset too large): check wiring and values.',
    cal_e_save: 'Saving failed.',
    cal_pt: 'Point {k}',
    cal_ver: 'Check {k}',
    cal_th_nom: 'Reading [{u}]',
    cal_th_ref: 'Multimeter [{u}]',
    cal_th_set: 'Set [{u}]',
    cal_th_meas: 'Measured [{u}]',
    cal_th_dev: 'Deviation',
    cal_save_hint: 'Real value = gain × nominal reading + offset. Once saved, it applies immediately to all measurements.',
    btn_save_cal: 'SAVE CALIBRATION',
    cal_saved: 'Calibration saved in memory (NVS).',
    cal_next_vin: 'The voltage output (3) can now be calibrated in loopback.',
    cal_next_iin: 'The current output (4) and transmitter simulation (5) can now be calibrated in loopback.',
    btn_close: 'CLOSE',
    cal_out_intro_vout: 'Automatic procedure, about 20 s: 5 uncorrected points (1, 3, 5, 7, 9 V), least-squares line, save and check at 1, 5 and 9 V with the correction.',
    cal_out_intro_iout: 'Automatic procedure, about 20 s: 5 uncorrected points (4, 8, 12, 16, 20 mA), least-squares line, save and check at 4, 12 and 20 mA with the correction.',
    cal_out_intro_sink: 'Automatic procedure, about 20 s: 5 uncorrected points (4, 8, 12, 16, 20 mA), least-squares line, save and check at 4, 12 and 20 mA with the correction.',
    cal_ref_ok: 'Reference: {n}, calibrated on {d}.',
    cal_ref_missing: '{n} is not calibrated: the result will depend on the nominal ADS1220 values (±0.25%). Better calibrate it first.',
    btn_start_auto: 'START CALIBRATION',
    cal_run_pt: 'Measuring point {k} of {n}…',
    cal_run_ver: 'Check {k} of {n}…',
    btn_abort: 'ABORT',
    cal_ver_max: 'Maximum check error',
    cal_c_timeout: 'The ADS1220 does not respond: procedure stopped, coefficients unchanged.',
    cal_c_off: 'Output switched off during the procedure (abort, external command or WiFi lost): coefficients unchanged.',
    cal_c_wiring: 'At the first point the input reads an unexpected value: check the wiring. Coefficients unchanged.',
    cal_c_limits: 'Coefficients out of limits (gain ±5% or offset): not saved. Check the wiring.',
    cal_c_verify: 'Check interrupted: the coefficients were already saved. Repeat to check them.',
    btn_repeat: 'REPEAT',
    i_cal_order_k: 'Order',
    i_cal_order: 'Inputs first (1, 2) with the multimeter, then outputs (3 – 5) in loopback: this way the outputs are also referred to the multimeter.',
    i_cal_in_k: 'Inputs',
    i_cal_in: 'Two points (1 and 9 V; 4 and 20 mA): real value = gain × nominal reading + offset.',
    i_cal_out_k: 'Outputs',
    i_cal_out: '5 uncorrected points, least-squares line, 3-point check with the correction; about 20 s.',
    i_cal_dmm_k: 'Multimeter',
    i_cal_dmm: 'At least 4 times more accurate than the ±0.3% target: ±0.075% or better in V DC and mA DC (5½ digits recommended).',
    i_cal_warm_k: 'Preparation',
    i_cal_warm: 'Instrument on for at least 15 minutes, stable room temperature.',
    i_cal_lim_k: 'Limits',
    i_cal_lim: 'Gain within ±5%, offset within 0.2 V or 0.5 mA: beyond that the coefficients are not saved (wrong wiring or fault).',
    i_cal_mem_k: 'Memory',
    i_cal_mem: 'Coefficients in NVS with date and ADS1220 temperature; they survive firmware updates (USB and OTA).',
    i_cal_vout_k: 'Voltage Output',
    i_cal_vout: 'F1 is outside the measuring loop: with load the error grows by I × 1.6 – 15 Ω (1 mA → up to 15 mV).',
    hm_ready: 'Instrument Ready',
    hm_ready_sub: 'All checks passed. Choose a function.',
    hm_check: 'To Check',
    hm_err: 'Problem Detected',
    is_dac: 'AD5412 test failed',
    is_adc: 'ADS1220 test failed',
    is_fault: 'AD5412 FAULT active',
    is_ot: 'AD5412 overtemperature',
    is_reset: 'Last restart: {r}',
    is_usb: 'Low USB voltage ({v} V)',
    is_adcerr: 'ADS1220 read errors: {n}',
    is_rssi: 'Weak WiFi signal ({r} dBm)',
    hm_c_power: 'Supply',
    hm_pow_field: 'AP63301 buck → 5 V',
    hm_pow_both: 'USB also connected ({v} V)',
    hm_c_out: 'Outputs',
    hm_c_cal: 'Calibration',
    hm_c_wifi: 'WiFi',
    hm_out_off: 'Off',
    hm_cal_n: '{n} of 5 channels',
    hm_cal_sub: '{n} of 5 channels calibrated',
    hm_inputs: 'Inputs',
    hm_inputs_hint: 'P2 INPUT · refreshed every second',
    hm_open: 'Open the measurement',
    hm_fn: 'Functions',
    hm_sim_sub: '2-wire · P1.2 SIM+',
    hm_i4_sub: 'Active source · P2.4 mA+',
    hm_i2_sub: 'Powered from P2.5 L+',
    hm_diag_sub: 'Components, tests, antenna',
    dg_title: 'Diagnostics',
    dg_sub: 'Component State, Tests and Antenna',
    dg_st_ok: 'ALL OK',
    dg_st_warn: 'TO CHECK',
    dg_st_bad: 'PROBLEM',
    k_pin: 'Voltage on GPIO1',
    k_iout_fault: 'IOUT Fault',
    k_status: 'Status Register',
    k_code_v: 'Voltage Code',
    k_code_i: 'Current Code',
    k_cpu: 'CPU Frequency',
    k_fw: 'Firmware',
    btn_test: 'RUN SPI TEST',
    dg_dac_hint: 'The test resets the AD5412: active outputs are switched off.',
    dg_adc_hint: 'Register read-back and a temperature conversion; measurements resume right after.',
    dg_dac_confirm: 'An output is active: the test switches it off. Continue?',
    dg_pass: 'Passed',
    dg_fail: 'Failed',
    dg_adc_drdy: 'DRDY OK · temperature {tc} °C · conversion {ms} ms',
    dg_adc_nodrdy: 'DRDY never arrives (timeout)',
    th_step: 'Step',
    th_exp: 'Expected',
    th_read: 'Read',
    th_stats: 'Min / mean / max (30 s)',
    th_rate: 'Rating',
    th_ch: 'Channel',
    dg_wifi: 'WiFi and Antenna',
    k_tx_set: 'Set TX Power',
    dg_clients: 'Connected devices',
    dg_noclient: 'No device',
    dg_nets: 'Nearby networks',
    btn_scan: 'SCAN',
    dg_scanning: 'Scanning…',
    dg_scan_age: 'Last: {s} s ago · {n} networks',
    dg_hidden: 'hidden',
    rssi_exc: 'Excellent',
    rssi_good: 'Good',
    rssi_poor: 'Poor',
    rssi_bad: 'Bad',
    dg_wifi_hint: 'Indicative thresholds (empirical, not from a datasheet): from −50 dBm excellent, −50…−67 good, −67…−75 poor, below −75 bad. The scan changes channel for about 2 s.',
    dg_io: 'LED and Buzzer',
    dg_led: 'RGB LED (test for 5 s, then back to automatic state)',
    c_red: 'Red',
    c_green: 'Green',
    c_blue: 'Blue',
    c_white: 'White',
    c_off: 'Off',
    dg_buzzer: 'Buzzer',
    k_freq: 'Frequency',
    btn_beep: 'BEEP',
    btn_sweep: 'SWEEP 2–6 kHz',
    btn_stop_snd: 'STOP',
    dg_legacy: 'Full test page (technical, Italian only)',
    fn_info: 'App Info',
    up_info: 'Information',
    up_title: 'App Info',
    up_sub: 'Version, Update and Memory',
    up_built: 'Built on',
    up_running: 'Partition in Use',
    up_hw: 'Hardware',
    up_author: 'Creator',
    up_fw: 'Update Firmware',
    up_fw_sub: '.bin File from the Browser',
    up_fs: 'Update Interface',
    up_fs_sub: 'Web Pages (LittleFS)',
    up_pick: 'Choose the .bin file',
    up_fw_hint: 'From the PC: .pio/build/esp32-s3fn8/firmware.bin (after pio run)',
    up_fs_hint: 'From the PC: .pio/build/esp32-s3fn8/littlefs.bin (after pio run -t buildfs)',
    up_fw_btn: 'UPDATE FIRMWARE',
    up_fs_btn: 'UPDATE INTERFACE',
    up_cur: 'Current Version',
    up_slot: 'Active → Next Partition',
    up_size: 'Firmware Size',
    up_max: 'Space for the New Firmware',
    up_fs_used: 'Space Used',
    up_e_ext: 'The file must have the .bin extension.',
    up_e_empty: 'The file is empty.',
    up_e_magic: 'Not an ESP32 firmware (0xE9 header missing): maybe it is littlefs.bin?',
    up_e_chip: 'Firmware for another chip (ID {id}): an ESP32-S3 firmware is needed.',
    up_e_big: 'File too large: {s} KB, maximum {m} KB.',
    up_e_isfw: 'This is a firmware, not the interface image: use the Update firmware panel.',
    up_ok_file: 'Valid file · {s} KB',
    up_confirm: 'An output is active: the update switches it off. Continue?',
    up_send: 'Sending {p} %',
    up_write: 'Writing and verifying…',
    up_reboot: 'Restarting the instrument…',
    up_wait: 'Waiting for reconnection… {s} s',
    up_done_fw: 'Firmware updated: {v}',
    up_done_fs: 'Interface updated: reloading the page…',
    up_fail: 'Update failed: {e}',
    up_timeout: 'The instrument does not answer after the restart: check the WiFi, otherwise reload via USB.',
    up_st_ready: 'READY',
    up_st_busy: 'IN PROGRESS',
    up_nvs: 'NVS Memory',
    up_nvs_sub: 'Calibration Coefficients',
    up_nvs_used: 'Entries Used / Total',
    up_th_ch: 'Channel',
    up_th_date: 'Date',
    up_copy: 'COPY THE COEFFICIENTS',
    up_copied: 'Copied to the clipboard: paste it into a file or a message.',
    up_copy_fail: 'Select the text below and copy it by hand.',
    up_dl: 'Download the JSON file',
    up_erase_h: 'Erase NVS',
    up_erase_txt: 'Erases the whole NVS memory: the calibration coefficients of the 5 channels (back to nominal values) and the settings saved by the system; the service PIN is kept. Copy the coefficients first.',
    up_erase_type: 'To confirm type ELIMINA',
    up_erase_btn: 'ERASE NVS AND RESTART',
    up_erase_confirm: 'Permanently erase the NVS? Calibrations will be lost.',
    up_erased: 'NVS erased, instrument restarted.',
    up_i_safe_k: 'Safety',
    up_i_safe: 'During the update the outputs are switched off and the LED blinks magenta; a running calibration blocks the update.',
    up_i_slots_k: 'Two Partitions',
    up_i_slots: 'The new firmware is written into the free partition (app0 / app1) and becomes active only if complete and verified: if the upload stops the current one stays.',
    up_i_keep_k: 'What Stays',
    up_i_keep: 'Calibrations (NVS) are kept after firmware and interface updates.',
    up_i_app_k: 'Android App',
    up_i_app: 'During the restart the app shows "Connection lost" and reconnects by itself.',
    up_i_fail_k: 'If Something Goes Wrong',
    up_i_fail: 'If the new firmware does not start, reload it via USB: pio run -e esp32-s3fn8 -t upload.',
    fn_bench: 'Bench Test',
    bt_title: 'Bench Test',
    bt_sub: 'Technical Test Bench',
    bt_st_off: 'OUTPUTS OFF',
    bt_st_on: 'OUTPUT ON',
    bt_st_fault: 'FAULT',
    bt_warn: 'Technical page: outputs here do not use the calibration. For normal use choose the Generate pages.',
    bt_out: 'Outputs Without Calibration',
    bt_set: 'SET',
    bt_rb: 'AD5412 read-back',
    bt_k_mode: 'Mode',
    bt_k_theory: 'Theoretical Value',
    bt_m_off: 'Off',
    bt_m_v: 'Voltage 0–10 V',
    bt_m_i: 'Current 4–20 mA',
    bt_m_s: 'Current 2W (sink)',
    bt_out_hint: 'DAC code from the nominal value (voltage 10 V × D / 4096, current 4 mA + 16 mA × D / 4096, AD5412 Table 17, eq. 2 and 6). Voltage: load ≥ 1 kΩ. Current: load ≤ about 950 Ω at 20 mA. 2W: loop powered externally on P1.2 SIM+ / P1.1 COM; with the sink on, P1.4 V+ is live too. Outputs switch off if no device stays connected to the WiFi.',
    bt_in: 'ADS1220 Inputs',
    bt_v_nom: 'Nominal Voltage',
    bt_i_nom: 'Nominal Current',
    bt_cal_val: 'Calibrated: {v}',
    bt_k_vrng: 'Voltage Min … Max',
    bt_k_irng: 'Current Min … Max',
    bt_k_flags: 'Over-Range / Negative',
    bt_k_att: 'ADC Attenuation (GPIO1)',
    bt_k_g17: 'GPIO17 · 24 V Present',
    bt_k_g18: 'GPIO18 · 5 V Present',
    bt_high: 'HIGH',
    bt_low: 'LOW',
    bt_led: 'LEDs',
    bt_rgb_apply: 'SHOW FOR 60 s',
    bt_rgb_auto: 'BACK TO AUTOMATIC',
    bt_led_test: 'Blue test LED (GPIO36)',
    bt_on: 'ON',
    bt_off: 'OFF',
    bt_dur: 'Duration',
    bt_cont: 'CONTINUOUS',
    bt_more: 'SPI Tests and Antenna',
    bt_more_txt: 'AD5412 and ADS1220 write/read-back tests, TX power, device signal and nearby networks are on the Diagnostics page.',
    bt_more_btn: 'OPEN DIAGNOSTICS',
    sc_in_title: 'Input Scaling',
    sc_in_sub: 'Measurement in Engineering Units',
    sc_out_title: 'Operator Panel',
    sc_out_sub: 'Command in % or Engineering Units',
    sc_value: 'Scaled value',
    sc_now: 'Current output',
    sc_cmd_off: 'Command (output off)',
    sc_pct: '{p} % of scale',
    sc_under: 'Under range',
    sc_over: 'Over range',
    sc_cmd_pct: 'Command in %',
    sc_cmd_eng: 'Command in Units',
    sc_elec: 'Signal to generate: {v}',
    sc_cmd_hint: 'With the output on the command applies immediately; with the output off it prepares the value, enabled with ENABLE.',
    sc_range: 'Signal range',
    sc_zero: 'Zero',
    sc_zero_h: '(Value at 0 %)',
    sc_span: 'Span',
    sc_span_h: '(Value at 100 %)',
    sc_unit: 'Unit',
    sc_dec: 'Decimals',
    fn_pid: 'Process Simulator',
    hm_pd_sub: 'Test the PLC PID',
    out_sim: 'Process simulator running',
    bt_m_i24: 'Current 0–24 mA (Simulator)',
    pd_title: 'Process Simulator',
    pd_idle: 'Press START: PLC output, valve and sensor will appear here',
    pd_go_s: 'START',
    pd_stop_s: 'STOP',
    pd_tab_dist: 'Disturb.',
    pd_tab_proc: 'Process',
    pd_tab_wire: 'Wiring',
    pd_tab_pid: 'PID',
    pd_osc: 'Oscillation',
    pd_sensor: 'Sensor',
    pd_m_integ_s: 'Level',
    pd_m_first_s: '1st Order',
    pd_m_second_s: '2nd Order',
    pd_dacfault: 'Real alarm: the sensor loop towards the AI input is open (P1.3 mA+ / P1.1 COM). Connect the PLC AI or check its configuration (4-wire transmitter).',
    pd_pre_flow_s: 'Fast · T 2 s',
    pd_pre_press_s: 'Medium · T 5 s',
    pd_pre_temp_s: 'Slow · T 60 s',
    pd_pre_level_s: 'Integrating',
    pd_cf_t: 'Start the Simulation?',
    pd_cf_proc: 'Process',
    pd_cf_out: 'Sensor → PLC',
    pd_cf_in: 'PLC → IO Tester',
    pd_cf_hint: 'Check the 4 wires and the PLC AI/AO configuration. The outputs switch on immediately.',
    pd_cf_wire: 'SEE WIRING',
    pd_sub: 'Test the PLC PID on a Simulated Process',
    pd_st_stop: 'STOPPED',
    pd_st_run: 'SIMULATING',
    pd_live: 'Simulation',
    pd_v_mv: 'PLC Output (MV)',
    pd_v_valve: 'Valve',
    pd_v_sim: 'Simulated',
    pd_v_pv: 'Sensor (PV)',
    pd_mvbad: 'PLC output missing or out of range: check wires 3 and 4 and that the PID is in automatic.',
    pd_fault_on: 'Simulated failure: {f} (for the PLC it is a real sensor failure)',
    pd_lg_mv: 'PLC output',
    pd_lg_vl: 'Valve',
    pd_lg_pv: 'Sensor',
    pd_chk: 'Wiring done and PLC input/output configured as in the diagram',
    pd_go: 'START SIMULATION',
    pd_stop: 'STOP SIMULATION',
    pd_dist_t: 'Disturbances and Failures',
    pd_dist_sub: 'Applied Immediately',
    pd_load: 'Load Disturbance',
    pd_amp: 'Oscillation',
    pd_period: 'Period',
    pd_noise: 'Sensor Noise',
    pd_drift: 'Sensor Drift',
    pd_fault: 'Sensor Failure',
    pd_f0: 'Normal',
    pd_f1: 'Broken Wire',
    pd_f2: 'Low Failure',
    pd_f3: 'High Failure',
    pd_f4: 'Frozen',
    pd_fault_hint_i: 'Broken wire: output open (0 mA). Low failure 3.6 mA and high 21 mA (NAMUR NE 43; 0 mA in the 0–20 range). Frozen: the value stays still while the process changes.',
    pd_fault_hint_v: 'Broken wire: output open. Low failure 0 V, high 10 V. Frozen: the value stays still while the process changes.',
    pd_pid_t: 'Suggested PID',
    pd_pid_sub: 'Starting Point for PID_Compact',
    pd_kc: 'Gain',
    pd_ti: 'Integral Time Ti',
    pd_td: 'Derivative Time Td',
    pd_cycle: 'Recommended OB Cycle',
    pd_pid_hint: 'SIMC rules with τc equal to the effective dead time (dead time + 10% of the stroke time): fast control without oscillation on the ideal model. With PV and output in % the gain is dimensionless. Check and refine on the PLC.',
    pd_proc_t: 'Process',
    pd_proc_sub: 'Simulated Valve and Process',
    pd_presets: 'Typical Processes',
    pd_pre_flow: 'Flow',
    pd_pre_press: 'Pressure',
    pd_pre_temp: 'Temperature',
    pd_pre_level: 'Level',
    pd_model: 'Model',
    pd_m_first: 'First Order',
    pd_m_second: 'Second Order',
    pd_m_integ: 'Level (Integrating)',
    pd_m_hint_0: 'Exponential response after the dead time: flows, pressures, many simple processes.',
    pd_m_hint_1: 'Two lags in series and dead time: temperatures, heat exchangers, slow processes.',
    pd_m_hint_2: 'The level rises or falls until inflow and outflow balance: without control the tank empties or overflows.',
    pd_gain: 'Gain',
    pd_t1: 'Time Constant T',
    pd_t2: 'Second Constant T2',
    pd_dead: 'Dead Time',
    pd_pv0: 'PV with Valve Closed',
    pd_tfill: 'Fill Time',
    pd_outflow: 'Outflow',
    pd_valve: 'Simulated Valve',
    pd_stroke: 'Stroke Time',
    pd_db: 'Dead Band',
    pd_lin: 'Linear',
    pd_eqp: 'Equal Percentage',
    pd_reset: 'RESTART FROM ZERO',
    pd_sig_t: 'Signals and Wiring',
    pd_in: 'PLC Output (MV) → Input P2',
    pd_out: 'Simulated Sensor (PV) → PLC Input',
    pd_wr_ai: 'Analog Input',
    pd_wr_ao: 'Analog Output',
    pd_wr_pv: 'Sensor (PV)',
    pd_wr_mv: 'PID Output (MV)',
    pd_wr_note: 'In TIA Portal: AI input as 4-wire transmitter (or voltage), AO output in current or voltage as chosen above. IO Tester reads the PLC output every 50 ms and updates the sensor every 50 ms.',
    pd_wr_note_sink: '2-wire sensor: the PLC AI input is configured as a 2-wire transmitter and powers the loop; IO Tester regulates the current like a real transmitter.',
    pd_info: 'How to Use It with TIA Portal',
    pd_i1_k: '1. Hardware',
    pd_i1: 'Configure an AI channel (measurement) and an AO channel (command) with the types chosen in Signals; connect the 4 wires of the diagram.',
    pd_i2_k: '2. PID_Compact',
    pd_i2: 'Call PID_Compact in a cyclic interrupt OB (OB30) with a cycle at least 10 times shorter than the time constant. Input_PER = AI channel, Output_PER = AO channel.',
    pd_i3_k: '3. Scaling',
    pd_i3: 'In the PID configuration scale the input 0…27648 → 0…100 % (for 4–20 mA, S7 raw value). This way PV, setpoint and output are all in %.',
    pd_i4_k: '4. Start',
    pd_i4: 'Press START at the bottom, then put the PID in automatic and give a setpoint: the chart shows PLC output, valve and sensor. You can also run the PID_Compact auto-tuning.',
    pd_i5_k: '5. Disturbances',
    pd_i5: 'Test the controller response with load disturbances, oscillations, noise and drift; test the diagnostics with sensor failures (broken wire, NAMUR).',
    pd_i6_k: 'Safety',
    pd_i6: 'Purple LED during the simulation; blinking red means only a real alarm (sensor loop open). The simulation stops and the outputs switch off if the phone leaves the WiFi, with SWITCH OFF OUTPUTS, during calibrations and updates.',
    grp_test: 'Tests',
    fn_tests: 'Guided Tests',
    hm_pg_sub: 'Converters, isolators, valves',
    pg_title: 'Guided Tests',
    pg_sub: 'Generate, Measure and Compare',
    pg_type: 'Test Type',
    pg_m_conv: 'Converter / Isolator',
    pg_m_valve: 'Valve / Positioner',
    pg_stim: 'Stimulus (output P1)',
    pg_resp: 'Device response (input P2)',
    pg_cmd: 'Positioner command (output P1)',
    pg_fb: 'Position feedback (input P2)',
    pg_vstep: 'Step size',
    pg_tol: 'Tolerance',
    pg_settle: 'Wait per Point',
    pg_vtimeout: 'Max Time per Step',
    pg_down: 'Also descending (hysteresis)',
    pg_chk: 'I wired as in the diagram and powered the device',
    pg_go_conv: 'START CONVERTER TEST',
    pg_go_valve: 'START STEP TEST',
    pg_go_db: 'MEASURE DEAD BAND',
    pg_res: 'Results',
    pg_res_empty: 'Results appear here during the test. Outputs switch off at the end or with ABORT.',
    pg_trend: 'Command and position (last 2 minutes)',
    pg_chart: 'Error per point (% of span)',
    pg_lg_cmd: 'Command',
    pg_lg_pos: 'Position',
    pg_lg_up: 'Ascending',
    pg_lg_dn: 'Descending',
    pg_lg_tol: 'Tolerance',
    pg_th_out: 'Stimulus',
    pg_th_exp: 'Expected',
    pg_th_read: 'Read',
    pg_th_err: 'Error',
    pg_th_cmd: 'Command',
    pg_th_pos: 'Position',
    pg_timeout: 'Timed out',
    pg_copy: 'COPY RESULTS',
    pg_ok: 'WITHIN TOLERANCE',
    pg_ko: 'OUT OF TOLERANCE',
    pg_r_errmax: 'Maximum Error',
    pg_r_hyst: 'Hysteresis',
    pg_r_tol: 'Tolerance',
    pg_r_t90: 'Maximum t90',
    pg_r_db_up: 'Dead Band Ascending',
    pg_r_db_dn: 'Dead Band Descending',
    pg_r_base: 'Position at 50 %',
    pg_s_point: 'Point {p} % ({k} of {n})…',
    pg_s_start: 'Moving the valve to 0 %…',
    pg_s_vstep: 'Step to {p} % ({k} of {n})…',
    pg_s_db0: 'Moving the valve to 50 %…',
    pg_s_db: 'Command {c} %…',
    pg_live: 'Command {c} % · position {p} %',
    pg_e_resp: 'The device does not respond: expected about {x}, read {r}. Check wiring and device supply.',
    pg_e_fb: 'Unexpected position feedback at 0 % ({p} %): check wiring and positioner calibration.',
    pg_dev_conv: 'Device under test',
    pg_dev_valve: 'Positioner',
    pg_pow_own: 'Separately powered',
    pg_pow_loop: 'Output powered by L+',
    pg_cmd_p: 'COMMAND +',
    pg_cmd_m: 'COMMAND −',
    pg_fb_p: 'FEEDBACK +',
    pg_fb_m: 'FEEDBACK −',
    pg_wr_conv: 'Device input on P1, device output on P2. Power the device with its own supply. P1 and P2 are isolated from each other: suitable for isolator tests too.',
    pg_wr_conv2f: 'Device input on P1; its 2-wire output is powered by the instrument (P2.5 L+) and measured on P2.4 mA+.',
    pg_wr_valve: '4–20 mA command on P1.3 mA+ / P1.1 COM; position feedback on P2 (2-wire powered by L+, or 4-wire). Positioner supply air open: the valve moves during the test.',
    pg_info: 'How It Works',
    pg_i_what_k: 'Test',
    pg_i_conv_what: 'The instrument generates 0-25-50-75-100 % of the chosen range (also descending), waits for settling and reads the device response',
    pg_i_err_k: 'Error',
    pg_i_conv_err: 'In % of the device output span; hysteresis = difference between ascending and descending at the same point. Typical tolerance of converters and isolators: 0.1 – 0.5 %',
    pg_i_iso_k: 'Isolation',
    pg_i_conv_iso: 'P1 (COM_OUT) and P2 (COM_IN) are isolated domains: the test works on galvanic isolators and barriers too',
    pg_i_valve_what: 'Command steps up and down; for each step it waits for a stable position (2.5 s within 0.2 %) and records error and response time',
    pg_i_t90_k: 't90',
    pg_i_valve_t90: 'Time to cover 90 % of the step. Resolution about 0.5 s: the input averages 10 readings (about 1 s)',
    pg_i_db_k: 'Dead Band',
    pg_i_valve_db: 'From 50 % the command rises in 0.1 % steps every 3 s until the position moves by 0.25 %; then the same descending',
    pg_i_load_k: 'Load',
    pg_i_valve_load: 'The 4–20 mA output drives up to about 950 Ω at 20 mA: enough for positioners (typically 300 – 600 Ω, i.e. 6 – 12 V)',
    al_title: 'Thresholds and Alarm',
    al_sub: 'In the Scaling Units',
    al_off: 'OFF',
    al_on: 'ON',
    al_lo: 'Low Threshold',
    al_hi: 'High Threshold',
    al_buzz: 'Instrument Buzzer',
    al_mute: 'SILENCE',
    al_st_off: 'Alarm off',
    al_st_ok: 'Normal',
    al_st_hi: 'HIGH ALARM',
    al_st_lo: 'LOW ALARM',
    al_st_sat: 'ALARM · OVER-RANGE',
    al_hint: 'An empty threshold is not checked. 1% of scale hysteresis to avoid chattering alarms. The buzzer sounds every second while the alarm lasts or until silenced; works with the page open.',
    fn_autotest: 'Self-Test',
    hm_at_sub: 'Instrument check in 1 minute',
    at_title: 'Self-Test',
    at_sub: 'Instrument Check in About 1 Minute',
    at_wr_main: 'Main wiring · 4 wires',
    at_wr_sink: '2W test · 2 wires',
    at_w1: 'Red: P1.4 V+ → P2.2 V+ (voltage)',
    at_w2: 'Blue: P1.3 mA+ → P2.4 mA+ (current)',
    at_w3: 'Black: P1.1 COM → P2.1 V− (common)',
    at_w4: 'Black jumper: P2.1 V− → P2.3 mA− (current common)',
    at_w5: 'Red: P2.5 L+ → P1.2 SIM+',
    at_w6: 'Black: P1.1 COM → P2.4 mA+',
    at_wr_note_main: 'Four wires, always the same: a test plug is handy. The blue wire passes over the red one, they do not touch. P1.2 SIM+ and P2.5 L+ stay free.',
    at_wr_note_sink: 'Remove ALL wires of the main connection, then connect only these two. The instrument powers the loop from L+ and measures the sink current.',
    at_info: 'What It Checks',
    at_i_spi_k: 'Chips',
    at_i_spi: 'AD5412 and ADS1220 register write and read-back through the isolators',
    at_i_v_k: 'Voltage',
    at_i_v: 'Output at 1, 5 and 9 V read back by the voltage input, plus noise',
    at_i_i_k: 'Current',
    at_i_i: 'Output at 4, 12 and 20 mA read back by the current input, plus noise and FAULT; then outputs off (≈ 0)',
    at_i_s_k: '2W (Optional)',
    at_i_s: 'Sink at 4, 12 and 20 mA powered from L+, with the second wiring',
    at_i_lim_k: 'Limits',
    at_i_lim: 'Voltage ±10 mV (0.1% of 10 V) · current ±30 µA (0.15% of 20 mA) · 2W ±50 µA · noise ≤ 1 mV / 2 µA: half of the ±0.3% target. At test: ±2 mV, within 20 µA',
    at_i_when_k: 'When to Run It',
    at_i_when: 'Before going on site, after a wiring mistake in the field and periodically to check drift',
    at_run: 'Test',
    at_run_sub: 'Calibrated Values, Read by the Inputs',
    at_chk_wire: 'I wired as in the diagram',
    at_chk_free: 'No other device connected to P1 and P2',
    at_go: 'START SELF-TEST',
    at_go_s: 'START 2W TEST',
    at_sink_btn: 'TEST THE 2W TOO (SECOND WIRING)',
    at_back_btn: 'BACK TO THE MAIN WIRING',
    at_th_test: 'Test',
    at_th_exp: 'Expected',
    at_th_read: 'Read',
    at_th_lim: 'Limit',
    at_s_spi: 'Chip test…',
    at_s_wire_v: 'Checking the voltage wiring…',
    at_s_wire_i: 'Checking the current wiring…',
    at_s_wire_s: 'Checking the 2W wiring…',
    at_s_v: 'Voltage {x} V…',
    at_s_i: 'Current {x} mA…',
    at_s_s: '2W {x} mA…',
    at_s_off: 'Outputs off…',
    at_r_spi_dac: 'AD5412 chip (outputs)',
    at_r_spi_adc: 'ADS1220 chip (inputs)',
    at_r_v: 'Voltage {x} V',
    at_r_i: 'Current {x} mA',
    at_r_s: '2W {x} mA',
    at_r_vnoise: 'Voltage noise',
    at_r_inoise: 'Current noise',
    at_r_fault: 'AD5412 FAULT',
    at_r_off: 'Outputs off',
    at_e_wire_v: 'Voltage wiring missing: at {x} the input reads {r}. Check wires 1 (red) and 3 (black).',
    at_e_wire_i: 'Current wiring missing: at {x} the input reads {r}. Check wire 2 (blue) and jumper 4.',
    at_e_wire_s: '2W wiring missing: at {x} the input reads {r}. Check wires 5 and 6 and that the others are removed.',
    at_e_adc: 'The ADS1220 does not update the readings.',
    at_aborted: 'Self-test aborted.',
    at_ok: 'INSTRUMENT OK',
    at_ko: 'TO CHECK',
    at_n_ok: '{a} of {b} tests passed',
    at_limit_note: 'The self-test compares the outputs with the instrument inputs: it finds faults and drift, but does not replace a check with an external reference instrument.',
    pin_panel: 'Service PIN',
    pin_panel_sub: 'Protects Updates, Calibration and Erase NVS',
    pin_state: 'State',
    pin_is_default: 'Default (1234): change it',
    pin_is_custom: 'Custom',
    pin_old: 'Current PIN',
    pin_new: 'New PIN (4–8 Digits)',
    pin_new2: 'Repeat the New PIN',
    pin_change: 'CHANGE PIN',
    pin_changed: 'PIN changed.',
    pin_mismatch: 'The two new PINs do not match.',
    pin_format: 'The PIN must have 4 to 8 digits.',
    pin_bad: 'Wrong PIN.',
    pin_locked: 'Too many wrong attempts: try again in {s} s.',
    pin_title: 'Service PIN',
    pin_ok: 'CONFIRM',
    pin_for_fw: 'Enter the PIN to update the firmware.',
    pin_for_fs: 'Enter the PIN to update the interface.',
    pin_for_nvs: 'Enter the PIN to erase the NVS.',
    pin_for_cal: 'Enter the PIN to save the calibration.',
    pin_for_cal_clear: 'Enter the PIN to clear the calibration.',
    sc_unit_free: 'No unit in the list: the typed text is used',
    sc_g_pct: 'Percentage',
    sc_g_press: 'Pressure',
    sc_g_temp: 'Temperature',
    sc_g_flow: 'Flow',
    sc_g_level: 'Level and distance',
    sc_g_mass: 'Weight',
    sc_g_speed: 'Speed and frequency',
    sc_g_elec: 'Electrical',
    sc_g_chem: 'Analysis and humidity',
    sc_err_span: 'Zero and span must differ.',
    bt_m_i0: 'Current 0–20 mA',
    gi_title: 'Generate Current 4W',
    gi_sub: '4–20 / 0–20 mA · Isolated Active Output',
    rb_loop_hint_i: 'Only when wiring P1.3 mA+ → P2.4 mA+ and P1.1 COM → P2.3 mA−',
    wr_plc_sub_i: 'PLC · 4–20 mA passive',
    wr_note_i: 'Connect only P1.3 mA+ and P1.1 COM. P1.2 SIM+ and P1.4 V+ stay free. The PLC input must be passive (4-wire): if the input powers the loop, use "Generate Current 2W". A multimeter, if needed, goes in series.',
    i_range_i: '4 – 20 mA (maximum 19.996 mA) or 0 – 20 mA (maximum 19.995 mA; linearity specified from 78 µA, AD5412 Table 2 note 4)',
    i_res_i: '3.91 µA · 12 bit',
    i_acc_i: '±0.08% of span at 25 °C (offset ±0.03% + gain ±0.05%, AD5412 Table 2, external RSET) · measured −0.11% in loopback',
    i_load_i: 'Maximum about 950 Ω at 20 mA (compliance AVDD − 2.5 V, AD5412 Table 2, minus protection resistors)',
    i_open_k: 'Open Circuit',
    i_open_i: 'Detected by the AD5412: FAULT and a warning on the page',
    i_iso_i: 'Isolated output: P1.1 COM is separate from the instrument ground',
    i_safe_i: 'Switches off by itself if the device leaves the WiFi; do not connect to voltage sources or loop-powering inputs',
  },
};

const LANG_KEY = 'iotester.lang';

/**
 * IT: Lingua attuale: parametro ?lang, poi quella salvata, poi quella del browser (italiano o inglese).
 * EN: Current language: ?lang parameter, then the saved one, then the browser's (Italian or English).
 */
function getLang() {
  const param = new URLSearchParams(location.search).get('lang');
  if (param && I18N[param]) return param;
  try {
    const saved = localStorage.getItem(LANG_KEY);
    if (saved && I18N[saved]) return saved;
  } catch (e) { /* IT: memoria del browser non disponibile / EN: browser storage unavailable */ }
  return (navigator.language || 'it').toLowerCase().startsWith('it') ? 'it' : 'en';
}

/**
 * IT: Restituisce il testo tradotto e sostituisce le variabili {nome}.
 * EN: Returns the translated text and replaces {name} variables.
 */
function t(key, vars = {}) {
  const dict = I18N[getLang()] || I18N.it;
  const text = dict[key] ?? I18N.it[key] ?? key;
  return text.replace(/\{(\w+)\}/g, (m, name) => (name in vars ? vars[name] : m));
}

/**
 * IT: Traduce gli elementi con data-i18n (testo) e data-i18n-title (title/aria-label); aggiorna i pulsanti lingua.
 * EN: Translates elements with data-i18n (text) and data-i18n-title (title/aria-label); updates language buttons.
 */
function applyI18n() {
  const lang = getLang();
  document.documentElement.lang = lang;
  document.querySelectorAll('[data-i18n]').forEach((el) => { el.textContent = t(el.dataset.i18n); });
  document.querySelectorAll('[data-i18n-title]').forEach((el) => {
    el.title = t(el.dataset.i18nTitle);
    el.setAttribute('aria-label', el.title);
  });
  document.querySelectorAll('[data-lang]').forEach((btn) => {
    btn.setAttribute('aria-pressed', String(btn.dataset.lang === lang));
  });
}

/**
 * IT: Cambia lingua, la salva e ritraduce la pagina; avvisa il resto dell'app con l'evento "langchange".
 * EN: Changes language, saves it and re-translates the page; notifies the app with a "langchange" event.
 */
function setLang(lang) {
  try { localStorage.setItem(LANG_KEY, lang); } catch (e) { /* IT/EN: vedi sopra / see above */ }
  const url = new URL(location.href);
  if (url.searchParams.has('lang')) {            // IT: il parametro vincerebbe sulla scelta / EN: the parameter would override the choice
    url.searchParams.delete('lang');
    history.replaceState(null, '', url);
  }
  applyI18n();
  document.dispatchEvent(new Event('langchange'));
}
